EgeGurtunca/smart-safety-system/docs/CMP3010_SmartSafetySystem_Report.docx

T.C.

BAHÇEŞEHİR UNIVERSITY

FACULTY OF ENGINEERING AND NATURAL SCIENCES

DEPARTMENT OF COMPUTER ENGINEERING

PROJECT FINAL REPORT

SMART SAFETY SYSTEM

AN IOT BASED GAS, FLAME AND HEAT DETECTOR WITH REMOTE CONTROL

CMP3010

Course Project

Ege Gürtünca

İSTANBUL, SEPTEMBER 2026

# TABLE OF CONTENTS

# 1 OVERVIEW

## 1.1 Problem Statement and Objectives

Gas leaks and house fires are still a common cause of injury and property damage. In Turkey many homes use LPG tubes for cooking and heating, so this is a real risk for a lot of families.

The problem with most detectors you can buy is simple: they only make a sound in the room where they are installed. If nobody is at home, nobody hears the buzzer. You find out that something happened when you come back, which can be hours later.

In this project I built a system that tries to fix that. It works like a normal detector when it is on its own, and it also sends its data to the internet so I can see it on my phone. I kept these two things separate on purpose. All the detection and the fan control run on the Arduino, and the Arduino never waits for the network. So if the Wi-Fi goes down or the server is offline, the detector still works. The internet part only adds reporting and a few optional commands on top.

My objectives were:

1. Detect three different things: gas with an MQ-2 sensor, flame with an infrared sensor, and a fast temperature rise with a DHT11.
2. React immediately on the device itself: turn on a 12 V fan through a relay, sound a buzzer, and show the state on two LEDs and a 16x2 LCD.
3. Save every reading to an SD card and to a database, so I can look at what happened afterwards.
4. Show live values, charts and an alarm list in an Android app and on a web page.
5. Send commands back to the device: turn the fan on, silence the buzzer, and change the alarm thresholds without uploading new code.
6. Notice when the system itself stops working, so a dead device is never shown as a safe device.

What I expected to finish, and what I did finish, is a working prototype on a breadboard. It is not a certified product. I did not test it against the standards that a real gas detector has to pass, and I would not tell anyone to use it instead of a proper detector.

## 1.2 Background Information

When I looked at what already exists, I found two groups of products.

The first group is normal detectors, the ones sold in hardware stores. Some of them are certified to standards like EN 50291 for carbon monoxide. They are cheap and they work, but they are closed boxes. You cannot read their data, you cannot connect anything to them, and the only thing they do is beep.

The second group is smart detectors like Nest Protect or Netatmo. These do send notifications to your phone, but they cost much more and they depend on the company's own cloud. If the company shuts the service down, you cannot do anything about it.

My project is somewhere between the two. It uses cheap parts, the server is mine, and it also has a fan, which neither group normally has.

About the sensors. The MQ-2 is a semiconductor sensor. Its resistance drops when there is LPG, methane, propane, hydrogen or smoke in the air. It cannot tell these gases apart, its readings drift with temperature and humidity, and it needs to be powered for 24 to 48 hours before the readings become stable. [2] The infrared flame sensor sees light in about the 760 to 1100 nm range, so it only detects a flame that is in front of it, inside a cone of roughly 60 degrees. The DHT11 measures temperature from 0 to 50 C with about 2 degrees of error, and humidity from 20 to 90 percent. [4]

Because the flame sensor only sees what is in front of it, a fire behind a sofa or a slow smouldering fire can produce no signal at all. That is why I also added heat detection based on how fast the temperature rises instead of a fixed limit. This is a standard method in fire detection. [3] A fixed limit is not very useful in a room, because a temperature that is strange in winter is normal in summer. But a rise of several degrees in one minute is strange in any season.

The benefit of this project is mostly the price. Buying every part new costs around 1350 TL, and I paid 545.59 TL of that because the lab supplied the boards and the sensors. Running it costs nothing, because every service I used has a free plan that is enough for one device. A family that would not spend money on a commercial smart detector can still get gas, flame and heat detection with a notification on the phone. And since everything is open, it can be repaired or extended later.

# 2 METHODOLOGY

## 2.1 Project design

The system has four parts. The Arduino Uno reads the sensors, decides if there is an alarm, and drives the relay, buzzer, LEDs and the LCD. The NodeMCU takes the readings from the Arduino over a serial connection and sends them to the internet. A Flask application on Render stores everything in a Supabase database. Finally an Android app written in Kotlin and a web page show the data to the user.

Figure 1 shows the whole system and how the data moves.

Figure 1. Overall design of the system and circuit schematic.

Readings go up once per second from the Arduino to the NodeMCU, and once every five seconds from the NodeMCU to the server as a small JSON message of about 88 bytes.

Commands go the other way, but I did not make a second connection for them. The server puts the commands inside its answer to the measurement POST, and the NodeMCU passes them to the Arduino. This way I did not need a second endpoint, a separate polling loop, or something like MQTT. The price is that a command can take up to five seconds to arrive, which is fine for a fan and a buzzer.

Commands are written as a state, not as an event. The server keeps one row with the wanted fan state, the mute flag and the thresholds, and the device gets the whole row every time. If one message is lost, the next one fixes it. If I had sent events like turn the fan on, a lost message would be lost forever.

There are three safety rules and I put all of them in the firmware, not in the app, so that a buggy app cannot break them:

7. The fan runs if alarm OR button OR remote command. So a remote command can only turn the fan on, never off. You cannot switch the fan off from the phone while there is a gas alarm, and that is on purpose.
8. The mute command only stops the buzzer. The fan and the LEDs keep working, and the server clears the mute by itself when the alarm ends. Otherwise one press would silence the system forever.
9. The thresholds are kept in EEPROM so they survive a power cut. They are only written when a value really changes, because EEPROM can only be written about 100000 times.

I had a number of problems while building this. Table 1 shows what they were and what I did about them.

Table 1. Problems I ran into and how I solved them.

Problem | What I did
ESP8266 pins are not 5 V safe | Added a voltage divider (1 kOhm and 2 kOhm) between Arduino D9 and NodeMCU D7, which gives 3.33 V
3.3 V signal going into a 5 V input | Connected it directly. The Arduino reads anything above 0.6 x VCC = 3.0 V as HIGH, so 3.3 V is enough. A divider here would break it
Commands arrived broken or two of them stuck together | SoftwareSerial cannot send and receive at the same time. I added an XOR checksum to every command, and the Arduino throws away any line that does not match
A cut command was applied only half way | Now the Arduino checks that all eight fields are there. If one is missing the line is thrown away
The Arduino ran out of RAM (80 percent used, LCD stayed blank, EEPROM values became garbage) | Wrapped all text in the F() macro so it is stored in flash instead of RAM. This brought it down to 64 percent
When the DHT11 failed, the word nan was sent and the whole JSON became invalid, so gas and flame data was lost too | Values that are not numbers are now sent as null
A dead device looked exactly like a safe device | The server now sends how old the last reading is. If it is older than 60 seconds the app and the web page show a warning instead of NORMAL
Two thresholds could never be reached | The DHT11 only measures 0 to 50 C and 20 to 90 percent humidity, so I limited the settings to those ranges

Table 2 lists what the system is supposed to do and how I checked it.

Table 2. Specifications and how they were tested.

Specification | Target | How I tested it
Gas and flame detection speed | Under 1 second | Timestamps in the Arduino serial monitor
Local reaction to an alarm | Fan, buzzer and LED | Watched it with a lighter near the flame sensor
How often data reaches the server | Every 5 seconds | Difference between created_at values in the database
How long a command takes | 5 seconds or less | Time between pressing the button and the CMD line appearing
Thresholds survive a power cut | Yes | Unplugged the board and read the values printed at start-up
Broken commands are rejected | All of them | Tested the checksum with five different broken lines
Noticing that the device is silent | 60 seconds or less | Record age reported by the server
Free RAM on the Arduino | More than 25 percent | Compiler output after uploading

## 2.2 Project components

Most of the boards and sensors came from the lab stock, and I bought the rest myself. My proposal form said ESP32 for the Wi-Fi side, but I built the system with a NodeMCU ESP8266 instead, because that is the board the lab had in stock when I collected my parts. It does the same job here, and I did not end up needing anything that the ESP32 has on top of it. Table 3 shows what I used, why each part suits the job, and what else I could have used.

Table 3. Components, why I chose them and the alternatives.

Component | Why I chose it | Alternative
Arduino Uno | 5 V logic works directly with all the sensors and the relay, and there are many examples online | Nano is the same but harder to prototype with. Mega has more RAM, but after the F() fix I did not need it
NodeMCU ESP8266 | It was the board available in the lab, and it has Wi-Fi and TLS built in, which is all this project needs | ESP32 has more memory and Bluetooth, but I did not need either
MQ-2 gas sensor | Detects LPG, methane and smoke, which covers what can happen in a kitchen | MQ-5 and MQ-9 are more specific but each covers less. One MQ-2 covers more
Infrared flame sensor | Reacts to an open flame immediately | UV sensors give fewer false alarms but are much more expensive
DHT11 | Gives temperature and humidity together and is cheap | DHT22 goes up to 80 C and is more accurate. This would make the heat alarm more useful
1 channel relay module | Keeps the 12 V fan circuit separate from the logic | A MOSFET would be silent and faster but gives no isolation
Micro SD card module | Keeps a local record even if the internet is down | The EEPROM on the Arduino is far too small for logging
16x2 LCD with I2C | Shows the values locally and only uses two pins | A parallel LCD would use six pins that I needed for other things

I did not need any special lab equipment. I worked on a breadboard at home with a multimeter and a soldering iron. For software I used the Arduino IDE for both boards, Android Studio for the app, and Python with Flask for the server. Render and Supabase host the server and the database on their free plans, so the running cost is zero.

# 3 WORK PLAN

## 3.1 Tasks and Time Line

I did this project alone, so instead of dividing the work between people I divided it into stages. First research and design, then building and coding, and finally testing and writing this report.

Two things decided the order. The server had to have the command endpoint before I could write the firmware that uses it, and the serial link from the NodeMCU to the Arduino had to work before I could test any remote control. The second one cost me the most time. I thought the command feature was finished for quite a while, but nothing was arriving at the Arduino. In the end it turned out that I had connected the transmit pin of one board to the transmit pin of the other, so neither direction could carry anything.

The term started on 27 July 2026, and the numbers in Table 4 are the weeks counted from that date. Nothing happened in the first two weeks. The project started in week 3, when I wrote the proposal, decided what the system had to do and ordered the parts I did not have. From there I worked until week 6, and the presentation is in week 7.

Table 4. The project Gantt chart, in weeks from 27 July 2026.

TASK LIST | 1 | 2 | 3 | 4 | 5 | 6 | 7
1. Research and design
1.1 Literature search and goals | | | X
1.2 Design and ordering the parts | | | X
2. Building and coding
2.1 Wiring the sensors, Arduino code | | | X | X
2.2 NodeMCU code and Wi-Fi | | | X | X
2.3 Flask server and database | | | X | X
2.4 Web page | | | | X | X
2.5 Android application | | | | | X | X
2.6 Command channel and integration | | | | X | X | X
3. Testing and documentation
3.1 Proposal | | | X
3.2 Testing and fixing | | | | | X | X
3.3 Report | | | | | | X
3.4 Presentation | | | | | | | X

## 3.2 Cost Proposal

Most of the parts came from the lab stock, so I did not pay for them. Table 5 lists everything the system uses, where each part came from, and what the parts I bought myself actually cost. The prices are the ones I paid at an online seller in September 2026. The server, the database and the notifications cost nothing, because the app asks my own server directly instead of using a push service, so I did not need a Firebase project or a Play Store account.

Table 5. Where each part came from and what I paid.

Component | Source | Cost (TL)
16x2 LCD with I2C adapter | Bought | 121.09
60x60x25 mm fan, 12 V 0.20 A | Bought | 149.51
8 x AA battery holder, the 12 V supply for the fan | Bought | 94.18
Male-male jumper wires, 40 pieces | Bought | 55.50
Male-female jumper wires, 40 pieces | Bought | 52.69
Push buttons, 10 pieces | Bought | 31.38
1 kOhm resistors, 50 pieces | Bought | 11.14
Green LEDs, 10 pieces | Bought | 10.65
Red LEDs, 10 pieces | Bought | 10.65
Heat shrink tubing, 1 m | Bought | 8.80
Arduino Uno | Lab stock | -
NodeMCU ESP8266 | Lab stock | -
MQ-2 gas sensor module | Lab stock | -
Infrared flame sensor module | Lab stock | -
DHT11 temperature and humidity sensor | Lab stock | -
1 channel relay module | Lab stock | -
Micro SD card module | Lab stock | -
220 Ohm resistors for the LEDs | Lab stock | -
Buzzer | Lab stock | -
Breadboard | Lab stock | -
Server, database and notifications | Free plans | 0
TOTAL I PAID | | 545.59

So the project cost me 545.59 TL. That number only covers the parts I bought. Someone who had to buy the lab parts as well would pay roughly 800 TL more for the two boards, the three sensors, the relay and the SD card module at the same seller, so building this system from scratch would cost around 1350 TL. The two most expensive items I bought, the fan and the battery holder, are both there because the fan runs on 12 V and has to stay separate from the 5 V logic.

# 4 REFERENCES

10. Arduino, Arduino Uno Rev3 Documentation, Available from: <https://docs.arduino.cc/hardware/uno-rev3> [3 September 2026]
11. Hanwei Electronics, MQ-2 Semiconductor Sensor for Combustible Gas, Datasheet, Available from: <https://www.pololu.com/file/download/MQ2.pdf> [3 September 2026]
12. National Fire Protection Association 2022, NFPA 72: National Fire Alarm and Signaling Code, chapter on heat detectors and rate of rise operation, NFPA, Quincy MA.
13. Aosong Electronics, DHT11 Humidity and Temperature Sensor, Datasheet, Available from: <https://www.mouser.com/datasheet/2/758/DHT11-Technical-Data-Sheet-Translated-Version-1143054.pdf> [3 September 2026]
14. Espressif Systems 2023, ESP8266EX Datasheet, version 6.9, Available from: <https://www.espressif.com/sites/default/files/documentation/0a-esp8266ex_datasheet_en.pdf> [3 September 2026]
15. European Committee for Standardization 2018, EN 50291-1: Electrical apparatus for the detection of carbon monoxide in domestic premises, CEN, Brussels.

# 5 PHOTOS

The photographs below have to be added by hand, because they cannot be produced from the source code.

16. The breadboard while building it, showing the sensor wiring and the voltage divider between the two boards.
17. The finished system running, with the LCD showing live values.
18. The system during an alarm, with the red LED on and the fan turning.
19. A screenshot of the Android app with the values, the controls and the charts.
20. A screenshot of the web page with the alarm chart and the alarm list.
21. A photo of me with the finished project.

# 6 APPENDIX

This part has the code. It is twelve files, grouped below by the part of the system they belong to. These parts only talk to each other through the interfaces I described in section 2.1.

## 6.1 Arduino firmware

This is the only part that can start an alarm or switch something on. It reads the three sensors, checks the gas, flame and heat conditions, drives the relay, buzzer, LEDs and LCD, writes a line to the SD card every two seconds, sends a measurement to the NodeMCU every second, and applies the commands that come back. The thresholds are kept in EEPROM. All the text is wrapped in the F() macro so it stays in flash. Without this the sketch fills up the 2 kB of RAM on the Uno and then the LCD stays blank and the EEPROM values get corrupted, which is exactly what happened to me. The tone() call only runs when the state changes, because that function sets up Timer2 again every time it is called and the loop runs a few thousand times per second.

#include <Wire.h>

#include <LiquidCrystal_I2C.h>

#include <DHT.h>

#include <SPI.h>

#include <SD.h>

#include <SoftwareSerial.h>

#include <EEPROM.h>

#define MQ2_PIN A0

#define FLAME_PIN A1

#define DHT_PIN 2

#define DHT_TYPE DHT11

#define BUZZER_PIN 3

#define BUTTON_PIN 4

#define RELAY_PIN 5

#define GREEN_LED 6

#define RED_LED 7

// Arduino -> NodeMCU

#define NODE_RX 8

#define NODE_TX 9

#define SD_CS 10

#define GAS_THRESHOLD_DEFAULT 400

#define FLAME_THRESHOLD_DEFAULT 80

// Sicaklik alarmi.

// TEMP_RISE: 60 saniyede bu kadar C yukselirse alarm. Yanginin imzasi

// mutlak sicaklik degil, hizli yukselistir -- mutlak esik yazin yanlis

// alarm verir, kisin gec kalir.

// TEMP_MAX: mutlak tavan, yavas yukselen durumu yakalar.

// DHT11 sadece 0-50 C olcuyor, 50 uzeri bir tavan hic tetiklenmez.

#define TEMP_RISE_DEFAULT 5

#define TEMP_MAX_DEFAULT 45

// 6 x 10 saniye = 60 saniyelik kayan pencere.

#define TEMP_HISTORY 6

#define TEMP_SAMPLE_MS 10000

#define RELAY_ON LOW

#define RELAY_OFF HIGH

// Nem uyari sinirlari. Alarm DEGIL: fan, buzzer ve role etkilenmez,

// sadece LCD'de donusumlu gosterilir.

//

// DHT11 nemi 20-90% RH araliginda olcuyor. Bu araligin disinda kalan

// bir sinir sensorden hic gelmeyecegi icin uyariyi olu birakir; bu

// yuzden varsayilanlar aralik icinde. Uzaktan ayarlanabilir.

#define HUMIDITY_HIGH_DEFAULT 80

#define HUMIDITY_LOW_DEFAULT 25

#define SCREEN_SWAP_MS 2000

// EEPROM: esikler elektrik kesintisinde kaybolmasin.

//

// Sihirli sayi 2 bayt: tek baytlik bir imzanin kartta kalmis rastgele

// bir bayta denk gelme ihtimali yuksek, o durumda cop degerler gecerli

// sanilir. Kayit duzeni degistiginde magic artiriliyor; boylece eski

// karttaki yarim veri ilk aciliste kendiliginden sifirlanir.

#define EEPROM_MAGIC 0xA55D

#define EEPROM_ADDR_MAGIC 0

#define EEPROM_ADDR_GAS 2

#define EEPROM_ADDR_FLAME 4

#define EEPROM_ADDR_TEMP_RISE 10

#define EEPROM_ADDR_TEMP_MAX 12

#define EEPROM_ADDR_TEMP_RISE_DEF 14

#define EEPROM_ADDR_TEMP_MAX_DEF 16

#define EEPROM_ADDR_HUM_HIGH 18

#define EEPROM_ADDR_HUM_LOW 20

#define EEPROM_ADDR_HUM_HIGH_DEF 22

#define EEPROM_ADDR_HUM_LOW_DEF 24

// Son damgalamada gecerli olan derleme varsayilanlari da saklaniyor.

// Kodda varsayilan degistirilip kart yeniden yuklendiginde EEPROM'daki

// eski deger degil derlenen deger kazansin diye: aksi halde #define

// degisikligi calisan sisteme hicbir zaman yansimaz.

#define EEPROM_ADDR_GAS_DEF 6

#define EEPROM_ADDR_FLAME_DEF 8

LiquidCrystal_I2C lcd(0x27, 16, 2);

DHT dht(DHT_PIN, DHT_TYPE);

SoftwareSerial nodeSerial(NODE_RX, NODE_TX);

bool sdOK = false;

// Uzaktan gelen komut durumu.

bool remoteFan = false;

bool remoteMute = false;

int gasThreshold = GAS_THRESHOLD_DEFAULT;

int flameThreshold = FLAME_THRESHOLD_DEFAULT;

int tempRise = TEMP_RISE_DEFAULT;

int tempMax = TEMP_MAX_DEFAULT;

int humidityHigh = HUMIDITY_HIGH_DEFAULT;

int humidityLow = HUMIDITY_LOW_DEFAULT;

// Sicaklik gecmisi: 10 saniyede bir ornek, 60 saniye once ile karsilastirilir.

float tempHistory[TEMP_HISTORY];

byte tempIndex = 0;

bool tempHistoryFull = false;

unsigned long lastTempSample = 0;

// DHT11 saniyede birden fazla okumada nan doner ve ~250 ms bloklar,

// bu yuzden zamanlayiciya bagli ve deger onbellekleniyor.

float temperature = NAN;

float humidity = NAN;

unsigned long lastLog = 0;

unsigned long lastLCD = 0;

unsigned long lastNodeSend = 0;

unsigned long lastDHT = 0;

unsigned long lastPrint = 0;

unsigned long lastScreenSwap = 0;

// LCD nem uyari ekranini mi gosteriyor?

bool showHumidityScreen = false;

// Buzzer su an caliyor mu? tone() gereksiz yere tekrar cagrilmasin.

bool buzzerOn = false;

// NodeMCU'dan gelen komut satiri. Uno'da RAM kisitli:

// SD + LCD + DHT + SoftwareSerial zaten yer yiyor, String kullanilmiyor.

char cmdBuf[48];

byte cmdLen = 0;

// -------------------------

// EEPROM

// -------------------------

void saveThresholds() {

uint16_t magic = EEPROM_MAGIC;

int gasDefault = GAS_THRESHOLD_DEFAULT;

int flameDefault = FLAME_THRESHOLD_DEFAULT;

// EEPROM.put degismeyen baytlari yazmiyor; ayrica sadece

// deger degistiginde cagriliyor (~100k yazim omru).

int riseDefault = TEMP_RISE_DEFAULT;

int maxDefault = TEMP_MAX_DEFAULT;

int humHighDefault = HUMIDITY_HIGH_DEFAULT;

int humLowDefault = HUMIDITY_LOW_DEFAULT;

EEPROM.put(EEPROM_ADDR_MAGIC, magic);

EEPROM.put(EEPROM_ADDR_GAS, gasThreshold);

EEPROM.put(EEPROM_ADDR_FLAME, flameThreshold);

EEPROM.put(EEPROM_ADDR_TEMP_RISE, tempRise);

EEPROM.put(EEPROM_ADDR_TEMP_MAX, tempMax);

EEPROM.put(EEPROM_ADDR_HUM_HIGH, humidityHigh);

EEPROM.put(EEPROM_ADDR_HUM_LOW, humidityLow);

EEPROM.put(EEPROM_ADDR_GAS_DEF, gasDefault);

EEPROM.put(EEPROM_ADDR_FLAME_DEF, flameDefault);

EEPROM.put(EEPROM_ADDR_TEMP_RISE_DEF, riseDefault);

EEPROM.put(EEPROM_ADDR_TEMP_MAX_DEF, maxDefault);

EEPROM.put(EEPROM_ADDR_HUM_HIGH_DEF, humHighDefault);

EEPROM.put(EEPROM_ADDR_HUM_LOW_DEF, humLowDefault);

}

void loadThresholds() {

uint16_t magic = 0;

EEPROM.get(EEPROM_ADDR_MAGIC, magic);

if (magic != EEPROM_MAGIC) {

// Ilk acilis ya da eski/bozuk icerik: varsayilanlari damgala.

saveThresholds();

return;

}

int gasDefault;

int flameDefault;

int riseDefault;

int maxDefault;

int humHighDefault;

int humLowDefault;

EEPROM.get(EEPROM_ADDR_GAS_DEF, gasDefault);

EEPROM.get(EEPROM_ADDR_FLAME_DEF, flameDefault);

EEPROM.get(EEPROM_ADDR_TEMP_RISE_DEF, riseDefault);

EEPROM.get(EEPROM_ADDR_TEMP_MAX_DEF, maxDefault);

EEPROM.get(EEPROM_ADDR_HUM_HIGH_DEF, humHighDefault);

EEPROM.get(EEPROM_ADDR_HUM_LOW_DEF, humLowDefault);

if (gasDefault != GAS_THRESHOLD_DEFAULT ||

flameDefault != FLAME_THRESHOLD_DEFAULT ||

riseDefault != TEMP_RISE_DEFAULT ||

maxDefault != TEMP_MAX_DEFAULT ||

humHighDefault != HUMIDITY_HIGH_DEFAULT ||

humLowDefault != HUMIDITY_LOW_DEFAULT) {

// Kodda varsayilan degistirilmis: derlenen deger kazanir,

// EEPROM'daki eski deger uzerine yazilir.

Serial.println(F("Kod varsayilanlari degismis, EEPROM sifirlandi"));

saveThresholds();

return;

}

int g;

int f;

int r;

int m;

int hh;

int hl;

EEPROM.get(EEPROM_ADDR_GAS, g);

EEPROM.get(EEPROM_ADDR_FLAME, f);

EEPROM.get(EEPROM_ADDR_TEMP_RISE, r);

EEPROM.get(EEPROM_ADDR_TEMP_MAX, m);

EEPROM.get(EEPROM_ADDR_HUM_HIGH, hh);

EEPROM.get(EEPROM_ADDR_HUM_LOW, hl);

// Cop deger okunursa varsayilanda kal.

if (g >= 0 && g <= 1023) {

gasThreshold = g;

}

if (f >= 0 && f <= 1023) {

flameThreshold = f;

}

if (r >= 1 && r <= 30) {

tempRise = r;

}

if (m >= 0 && m <= 50) {

tempMax = m;

}

// DHT11 araligi disinda bir esik uyariyi olu birakir.

if (hh >= 20 && hh <= 90 && hl >= 20 && hl <= 90 && hh > hl) {

humidityHigh = hh;

humidityLow = hl;

}

}

// -------------------------

// KOMUT: #F1,M0,G400,L80,R5,X45,H80,W25

// -------------------------

// Anahtar yoksa ya da ardindan rakam gelmiyorsa bu deger doner.

// Mevcut degere sessizce dusmek, kesilmis bir satirin yarim

// uygulanmasi anlamina gelir.

#define FIELD_MISSING -32000

int fieldValue(const char *line, char key) {

const char *p = strchr(line, key);

if (!p) {

return FIELD_MISSING;

}

p++;

if (*p == '-' || *p == '+') {

p++;

}

if (!isdigit((unsigned char)*p)) {

return FIELD_MISSING;

}

return atoi(strchr(line, key) + 1);

}

/**

* XOR sagalamasi: '#' ile '*' arasindaki karakterlerin XOR'u.

*

* SoftwareSerial yari cift yonlu -- Arduino nodeSerial.print() ile

* veri gonderirken (saniyede bir, kesmeler kapali) ayni anda alamiyor.

* Komut tam o pencerede gelirse baytlar kayboluyor, satir sonu da

* kaybolunca iki komut birbirine yapisiyor. Bozuk satiri uygulamak

* cihaza sacma esik yazar; sagalama tutmuyorsa satiri atiyoruz.

* NodeMCU 5 saniyede bir tekrar gonderiyor, kayip sorun degil.

*/

bool checksumOk(const char *line) {

const char *star = strrchr(line, '*');

if (!star || star == line) {

return false;

}

byte sum = 0;

for (const char *p = line + 1; p < star; p++) {

sum ^= (byte)(*p);

}

return (byte)strtol(star + 1, NULL, 16) == sum;

}

void applyCommand(const char *line) {

if (line[0] != '#') {

return;

}

if (!checksumOk(line)) {

Serial.print(F("CMD BOZUK, atlandi: "));

Serial.println(line);

return;

}

int fanValue = fieldValue(line, 'F');

int muteValue = fieldValue(line, 'M');

int g = fieldValue(line, 'G');

int f = fieldValue(line, 'L');

int r = fieldValue(line, 'R');

int x = fieldValue(line, 'X');

int hh = fieldValue(line, 'H');

int hl = fieldValue(line, 'W');

// Sekiz alanin biri bile eksikse satir kesilmis demektir.

if (fanValue == FIELD_MISSING || muteValue == FIELD_MISSING ||

g == FIELD_MISSING || f == FIELD_MISSING ||

r == FIELD_MISSING || x == FIELD_MISSING ||

hh == FIELD_MISSING || hl == FIELD_MISSING) {

Serial.print(F("CMD EKSIK ALAN, atlandi: "));

Serial.println(line);

return;

}

remoteFan = fanValue != 0;

remoteMute = muteValue != 0;

if (g >= 0 && g <= 1023 &&

f >= 0 && f <= 1023 &&

r >= 1 && r <= 30 &&

x >= 0 && x <= 50 &&

hh >= 20 && hh <= 90 && hl >= 20 && hl <= 90 && hh > hl &&

(g != gasThreshold || f != flameThreshold ||

r != tempRise || x != tempMax ||

hh != humidityHigh || hl != humidityLow)) {

gasThreshold = g;

flameThreshold = f;

tempRise = r;

tempMax = x;

humidityHigh = hh;

humidityLow = hl;

saveThresholds();

Serial.print(F("EEPROM yazildi G:"));

Serial.print(gasThreshold);

Serial.print(F(" L:"));

Serial.print(flameThreshold);

Serial.print(F(" R:"));

Serial.print(tempRise);

Serial.print(F(" X:"));

Serial.print(tempMax);

Serial.print(F(" H:"));

Serial.print(humidityHigh);

Serial.print(F(" W:"));

Serial.println(humidityLow);

}

Serial.print(F("CMD alindi: "));

Serial.println(line);

}

void readCommand() {

while (nodeSerial.available()) {

char c = nodeSerial.read();

if (c == '\n' || c == '\r') {

if (cmdLen > 0) {

cmdBuf[cmdLen] = '\0';

applyCommand(cmdBuf);

cmdLen = 0;

}

continue;

}

if (cmdLen < sizeof(cmdBuf) - 1) {

cmdBuf[cmdLen++] = c;

} else {

// Tasma: bozuk satiri at, yarim komut uygulama.

cmdLen = 0;

}

}

}

void setup() {

Serial.begin(9600);

nodeSerial.begin(9600);

pinMode(BUZZER_PIN, OUTPUT);

pinMode(BUTTON_PIN, INPUT_PULLUP);

pinMode(RELAY_PIN, OUTPUT);

pinMode(GREEN_LED, OUTPUT);

pinMode(RED_LED, OUTPUT);

digitalWrite(RELAY_PIN, RELAY_OFF);

digitalWrite(GREEN_LED, HIGH);

digitalWrite(RED_LED, LOW);

noTone(BUZZER_PIN);

loadThresholds();

for (byte i = 0; i < TEMP_HISTORY; i++) {

tempHistory[i] = NAN;

}

dht.begin();

lcd.init();

lcd.backlight();

lcd.clear();

lcd.setCursor(0, 0);

lcd.print(F("SMART SYSTEM"));

lcd.setCursor(0, 1);

lcd.print(F("Starting..."));

delay(1500);

if (SD.begin(SD_CS)) {

sdOK = true;

if (!SD.exists("log.csv")) {

File file = SD.open("log.csv", FILE_WRITE);

if (file) {

file.println(

F("Time,Temperature,Humidity,Gas,Flame,Button,Fan,Alarm")

);

file.close();

}

}

Serial.println(F("SD OK"));

} else {

Serial.println(F("SD FAILED"));

}

Serial.print(F("Esikler G:"));

Serial.print(gasThreshold);

Serial.print(F(" L:"));

Serial.print(flameThreshold);

Serial.print(F(" R:"));

Serial.print(tempRise);

Serial.print(F(" X:"));

Serial.print(tempMax);

Serial.print(F(" H:"));

Serial.print(humidityHigh);

Serial.print(F(" W:"));

Serial.println(humidityLow);

lcd.clear();

lcd.print(F("SYSTEM READY"));

delay(1000);

lcd.clear();

}

void loop() {

// -------------------------

// KOMUT OKU

// -------------------------

readCommand();

// -------------------------

// SENSORLAR

// -------------------------

int gasValue = analogRead(MQ2_PIN);

int flameValue = analogRead(FLAME_PIN);

if (millis() - lastDHT >= 2000) {

lastDHT = millis();

temperature = dht.readTemperature();

humidity = dht.readHumidity();

}

bool buttonPressed =

(digitalRead(BUTTON_PIN) == LOW);

// -------------------------

// ALARM

// -------------------------

bool gasAlarm =

gasValue >= gasThreshold;

bool flameAlarm =

flameValue <= flameThreshold;

// -------------------------

// SICAKLIK

//

// 10 saniyede bir ornek alinip 60 saniye oncekiyle karsilastiriliyor.

// Yanginin imzasi mutlak sicaklik degil hizli yukselis; mutlak esik

// tek basina yazin yanlis alarm verir, kisin gec kalir.

// -------------------------

if (millis() - lastTempSample >= TEMP_SAMPLE_MS) {

lastTempSample = millis();

tempHistory[tempIndex] = temperature;

tempIndex = (tempIndex + 1) % TEMP_HISTORY;

if (tempIndex == 0) {

tempHistoryFull = true;

}

}

bool tempAlarm = false;

if (!isnan(temperature)) {

if (temperature >= tempMax) {

tempAlarm = true;

}

if (tempHistoryFull) {

// tempIndex, uzerine yazilacak olan slot: yani en eski ornek.

float oldest = tempHistory[tempIndex];

if (!isnan(oldest) && (temperature - oldest) >= tempRise) {

tempAlarm = true;

}

}

}

bool alarm =

gasAlarm || flameAlarm || tempAlarm;

// -------------------------

// FAN

// -------------------------

// Uzaktan sadece ACILIR. Alarm varken telefondan fan kapatilamaz.

bool fanOn = alarm || buttonPressed || remoteFan;

digitalWrite(

RELAY_PIN,

fanOn ? RELAY_ON : RELAY_OFF

);

// -------------------------

// LED

// -------------------------

if (alarm) {

digitalWrite(RED_LED, HIGH);

digitalWrite(GREEN_LED, LOW);

} else {

digitalWrite(RED_LED, LOW);

digitalWrite(GREEN_LED, HIGH);

}

// -------------------------

// BUZZER

// -------------------------

// Susturma sadece sesi keser; fan ve LED calismaya devam eder.

//

// tone() her cagrildiginda Timer2'yi bastan kuruyor. Dongu saniyede

// binlerce kez dondugu icin surekli cagrilirsa dalga formu hic

// tamamlanamaz ve buzzer ya hic otmez ya cilizca oter. Bu yuzden

// sadece durum degistiginde cagriliyor.

bool wantBuzzer = alarm && !remoteMute;

if (wantBuzzer != buzzerOn) {

buzzerOn = wantBuzzer;

if (buzzerOn) {

tone(BUZZER_PIN, 1000);

} else {

noTone(BUZZER_PIN);

}

}

// -------------------------

// LCD

// -------------------------

// Nem sinir disindaysa LCD 2 saniye normal degerleri, 2 saniye

// uyariyi gosterir. Alarm varken uyari ekrani devre disi:

// o anda ekranda sensor degerleri durmali.

bool humidityWarn =

!isnan(humidity) &&

(humidity >= humidityHigh || humidity <= humidityLow);

if (!humidityWarn || alarm) {

showHumidityScreen = false;

lastScreenSwap = millis();

} else if (millis() - lastScreenSwap >= SCREEN_SWAP_MS) {

lastScreenSwap = millis();

showHumidityScreen = !showHumidityScreen;

}

if (millis() - lastLCD >= 1000) {

lastLCD = millis();

lcd.clear();

if (showHumidityScreen) {

lcd.setCursor(0, 0);

lcd.print(F("NEM UYARISI"));

lcd.setCursor(0, 1);

lcd.print(F("%"));

lcd.print(humidity, 0);

if (humidity >= humidityHigh) {

lcd.print(F(" COK NEMLI"));

} else {

lcd.print(F(" COK KURU"));

}

} else {

lcd.setCursor(0, 0);

if (isnan(temperature)) {

lcd.print(F("T:ERR"));

} else {

lcd.print(F("T:"));

lcd.print(temperature, 1);

lcd.print(F("C"));

}

lcd.print(F(" "));

if (isnan(humidity)) {

lcd.print(F("H:ERR"));

} else {

lcd.print(F("H:"));

lcd.print(humidity, 0);

lcd.print(F("%"));

}

lcd.setCursor(0, 1);

lcd.print(F("G:"));

lcd.print(gasValue);

lcd.print(F(" F:"));

lcd.print(flameValue);

if (alarm) {

lcd.setCursor(15, 1);

lcd.print(remoteMute ? "M" : "!");

}

}

}

// -------------------------

// SD CARD

// -------------------------

if (sdOK && millis() - lastLog >= 2000) {

lastLog = millis();

File file =

SD.open("log.csv", FILE_WRITE);

if (file) {

file.print(millis());

file.print(",");

file.print(temperature);

file.print(",");

file.print(humidity);

file.print(",");

file.print(gasValue);

file.print(",");

file.print(flameValue);

file.print(",");

file.print(buttonPressed);

file.print(",");

file.print(fanOn);

file.print(",");

file.println(alarm);

file.close();

}

}

// -------------------------

// NODEMCU'YA VERI GONDER

// FN son alan olmali, NodeMCU satir sonuna kadar okuyor.

// -------------------------

if (millis() - lastNodeSend >= 1000) {

lastNodeSend = millis();

nodeSerial.print(F("@"));

nodeSerial.print(F("T="));

nodeSerial.print(temperature);

nodeSerial.print(F(",H="));

nodeSerial.print(humidity);

nodeSerial.print(F(",G="));

nodeSerial.print(gasValue);

nodeSerial.print(F(",F="));

nodeSerial.print(flameValue);

nodeSerial.print(F(",A="));

nodeSerial.print(alarm);

nodeSerial.print(F(",B="));

nodeSerial.print(buttonPressed);

nodeSerial.print(F(",FN="));

nodeSerial.println(fanOn);

}

// -------------------------

// ARDUINO SERIAL MONITOR

// -------------------------

if (millis() - lastPrint >= 1000) {

lastPrint = millis();

Serial.print(F("Temperature: "));

Serial.print(temperature);

Serial.print(F(" | Humidity: "));

Serial.print(humidity);

Serial.print(F(" | Gas: "));

Serial.print(gasValue);

Serial.print(F("/"));

Serial.print(gasThreshold);

Serial.print(F(" | Flame: "));

Serial.print(flameValue);

Serial.print(F("/"));

Serial.print(flameThreshold);

Serial.print(F(" | Button: "));

Serial.print(buttonPressed);

Serial.print(F(" | Fan: "));

Serial.print(fanOn);

Serial.print(F(" | RemoteFan: "));

Serial.print(remoteFan);

Serial.print(F(" | Mute: "));

Serial.print(remoteMute);

Serial.print(F(" | TempAlarm: "));

Serial.print(tempAlarm);

Serial.print(F(" | Alarm: "));

Serial.println(alarm);

}

}

## 6.2 NodeMCU firmware

This part only carries data, it makes no decisions. It reads the line coming from the Arduino, sends it to the server as JSON over TLS, takes the command out of the answer, and passes it back to the Arduino with a checksum at the end. Values that are not numbers, which happens when the DHT11 fails to read, are sent as null. Sending the word nan made the JSON invalid and the server rejected the whole record. The receive buffer is set to 256 bytes because the TLS handshake blocks the loop for one to three seconds and the Arduino keeps sending during that time.

#include <ESP8266WiFi.h>

#include <SoftwareSerial.h>

#include <ESP8266HTTPClient.h>

#include <WiFiClientSecureBearSSL.h>

// =================================================

// WIFI

// =================================================

// Kendi ag bilgilerini gir

const char* ssid = "YOUR_WIFI_SSID";

const char* password = "YOUR_WIFI_PASSWORD";

// =================================================

// RENDER API

// =================================================

const char* serverURL =

"https://smart-safety-system-y11a.onrender.com/api/data";

// Render'daki API_TOKEN ortam degiskeniyle ayni olmali.

const char* apiToken = "YOUR_API_TOKEN";

// =================================================

// ARDUINO <-> NODEMCU

//

// D7 = RX <- Arduino D9 (TX), gerilim bolucu uzerinden

// Bolucu sart: Arduino 5V veriyor, ESP8266 pinleri

// 5V toleransli degil.

//

// D6 = TX -> Arduino D8 (RX), dogrudan

// Bolucu YOK: 3.3V zaten Arduino'nun HIGH esigi olan

// 3.0V'un ustunde. Bolunse esigin altina duserdi.

// =================================================

SoftwareSerial arduinoSerial(D7, D6);

// =================================================

// SENSOR VALUES

// =================================================

String temperature = "--";

String humidity = "--";

String gas = "--";

String flame = "--";

String alarm = "0";

String fan = "0";

String button = "0";

// =================================================

// KOMUT (sunucudan inen istenen durum)

// =================================================

int cmdFan = 0;

int cmdMute = 0;

int cmdGas = 400;

int cmdFlame = 80;

int cmdTempRise = 5;

int cmdTempMax = 45;

int cmdHumHigh = 80;

int cmdHumLow = 25;

unsigned long lastSend = 0;

unsigned long lastBlink = 0;

bool ledState = HIGH;

// =================================================

// LOG

//

// Log sadece USB seri porta gidiyor, RAM'de biriktirilmiyor.

// HTTPS el sikismasi tek basina ~20 KB heap istiyor; birikip

// duran String'ler heap'i parcalayip baglantiyi dusuruyor.

// =================================================

void addLog(String text) {

Serial.println(text);

}

// =================================================

// JSON YARDIMCISI

//

// Arduino DHT okuyamazsa "nan" gonderiyor. Ham haliyle JSON'a

// girerse gecersiz JSON olur, Flask 400 doner ve o turun TAMAMI

// -- gaz ve alev dahil -- kaybolur. Sayi degilse null yaz.

// =================================================

String jsonNumber(String value) {

value.trim();

if (value.length() == 0)

return "null";

char first = value.charAt(0);

if (!isDigit(first) && first != '-' && first != '+')

return "null";

return value;

}

// =================================================

// SUNUCU CEVABINDAN SAYI CEK

// =================================================

int extractInt(String src, String key, int fallback) {

int start = src.indexOf("\"" + key + "\":");

if (start < 0)

return fallback;

start += key.length() + 3;

int end = start;

while (end < (int)src.length()) {

char c = src.charAt(end);

if (!isDigit(c) && c != '-')

break;

end++;

}

if (end == start)

return fallback;

return src.substring(start, end).toInt();

}

// =================================================

// ARDUINO DATA READER

// =================================================

void readArduinoData() {

while (arduinoSerial.available()) {

String data =

arduinoSerial.readStringUntil('\n');

data.trim();

if (data.length() == 0)

continue;

// Ham satiri her zaman bas. Bu satir olmadan "hic byte gelmiyor" ile

// "bozuk byte geliyor" ayirt edilemiyor.

addLog("ARDUINO: " + data);

// ---------------------------------------------

// Beklenen format:

//

// @T=25.9,H=74,G=76,F=160,A=0,B=0,FN=0

// ---------------------------------------------

if (!data.startsWith("@")) {

addLog(" (@ ile baslamiyor, atlandi)");

continue;

}

data.remove(0, 1);

int start;

int end;

// ---------------------------------------------

// TEMPERATURE

// ---------------------------------------------

start = data.indexOf("T=");

if (start >= 0) {

end = data.indexOf(',', start);

if (end >= 0) {

temperature = data.substring(start + 2, end);

}

}

// ---------------------------------------------

// HUMIDITY

// ---------------------------------------------

start = data.indexOf("H=");

if (start >= 0) {

end = data.indexOf(',', start);

if (end >= 0) {

humidity = data.substring(start + 2, end);

}

}

// ---------------------------------------------

// GAS

// ---------------------------------------------

start = data.indexOf("G=");

if (start >= 0) {

end = data.indexOf(',', start);

if (end >= 0) {

gas = data.substring(start + 2, end);

}

}

// ---------------------------------------------

// FLAME

// ---------------------------------------------

start = data.indexOf("F=");

if (start >= 0) {

end = data.indexOf(',', start);

if (end >= 0) {

flame = data.substring(start + 2, end);

}

}

// ---------------------------------------------

// ALARM

// ---------------------------------------------

start = data.indexOf("A=");

if (start >= 0) {

end = data.indexOf(',', start);

if (end >= 0) {

alarm = data.substring(start + 2, end);

}

}

// ---------------------------------------------

// BUTTON

// ---------------------------------------------

start = data.indexOf("B=");

if (start >= 0) {

end = data.indexOf(',', start);

if (end >= 0) {

button = data.substring(start + 2, end);

}

}

// ---------------------------------------------

// FAN (son alan, satir sonuna kadar)

// ---------------------------------------------

start = data.indexOf("FN=");

if (start >= 0) {

fan = data.substring(start + 3);

}

addLog(

"PARSED -> T:" + temperature +

" H:" + humidity +

" G:" + gas +

" F:" + flame +

" BTN:" + button +

" FAN:" + fan +

" ALARM:" + alarm

);

}

}

// =================================================

// KOMUTU ARDUINO'YA GONDER

// =================================================

void sendCommandToArduino() {

String line =

"#F" + String(cmdFan) +

",M" + String(cmdMute) +

",G" + String(cmdGas) +

",L" + String(cmdFlame) +

",R" + String(cmdTempRise) +

",X" + String(cmdTempMax) +

",H" + String(cmdHumHigh) +

",W" + String(cmdHumLow);

// XOR sagalamasi. Arduino'nun SoftwareSerial'i gonderirken alamiyor;

// cakisma olursa satir bozuluyor ya da iki komut birbirine yapisiyor.

// Sagalama tutmazsa Arduino satiri atiyor.

byte sum = 0;

for (unsigned int i = 1; i < line.length(); i++) {

sum ^= (byte)line[i];

}

char tail[5];

sprintf(tail, "*%02X", sum);

line += tail;

arduinoSerial.println(line);

addLog("CMD -> " + line);

}

// =================================================

// SEND DATA TO RENDER

// =================================================

void sendToServer() {

if (WiFi.status() != WL_CONNECTED) {

addLog("ERROR: WiFi disconnected");

return;

}

// HTTPS client

std::unique_ptr<BearSSL::WiFiClientSecure> client(

new BearSSL::WiFiClientSecure

);

// Test/prototype icin certificate verification kapali

client->setInsecure();

HTTPClient https;

if (!https.begin(*client, serverURL)) {

addLog("ERROR: HTTPS connection failed");

return;

}

https.addHeader("Content-Type", "application/json");

https.addHeader("X-Auth", apiToken);

// ---------------------------------------------

// JSON

// ---------------------------------------------

String json = "{";

json += "\"temperature\":";

json += jsonNumber(temperature);

json += ",";

json += "\"humidity\":";

json += jsonNumber(humidity);

json += ",";

json += "\"gas\":";

json += jsonNumber(gas);

json += ",";

json += "\"flame\":";

json += jsonNumber(flame);

json += ",";

json += "\"button\":";

json += jsonNumber(button);

json += ",";

json += "\"fan\":";

json += jsonNumber(fan);

json += ",";

json += "\"alarm\":";

json += jsonNumber(alarm);

json += "}";

addLog("JSON: " + json);

// ---------------------------------------------

// POST

// ---------------------------------------------

int httpCode = https.POST(json);

if (httpCode > 0) {

addLog("HTTP CODE: " + String(httpCode));

String response = https.getString();

addLog("SERVER: " + response);

// -------------------------------------------

// Komut cevaba binmis halde geliyor:

// {"success":true,"cmd":{"fan":0,"mute":0,"gt":400,"ft":80,"tr":5,"tm":45,"hh":80,"hl":25}}

// -------------------------------------------

if (httpCode == 200 && response.indexOf("\"cmd\"") >= 0) {

int fanValue = extractInt(response, "fan", -1);

int muteValue = extractInt(response, "mute", -1);

int gasValue = extractInt(response, "gt", -1);

int flameValue = extractInt(response, "ft", -1);

int riseValue = extractInt(response, "tr", -1);

int maxValue = extractInt(response, "tm", -1);

int humHighValue = extractInt(response, "hh", -1);

int humLowValue = extractInt(response, "hl", -1);

if (fanValue >= 0 && muteValue >= 0 &&

gasValue >= 0 && flameValue >= 0 &&

riseValue >= 0 && maxValue >= 0 &&

humHighValue >= 0 && humLowValue >= 0) {

cmdFan = fanValue;

cmdMute = muteValue;

cmdGas = gasValue;

cmdFlame = flameValue;

cmdTempRise = riseValue;

cmdTempMax = maxValue;

cmdHumHigh = humHighValue;

cmdHumLow = humLowValue;

sendCommandToArduino();

} else {

addLog("CMD: eksik alan, gonderilmedi");

}

}

} else {

addLog("POST ERROR: " + https.errorToString(httpCode));

}

https.end();

}

// =================================================

// SETUP

// =================================================

void setup() {

// USB serial

Serial.begin(9600);

// Arduino serial.

//

// Varsayilan 64 baytlik tampon yetmiyor: sendToServer() TLS el

// sikismasi icin 1-3 saniye bloklarken Arduino saniyede bir ~45

// baytlik satir gonderiyor, ikinci satirda tampon tasiyor.

arduinoSerial.begin(9600, SWSERIAL_8N1, D7, D6, false, 256);

// Satir sonu gelmezse 1 saniye kilitlenmesin.

arduinoSerial.setTimeout(200);

pinMode(LED_BUILTIN, OUTPUT);

digitalWrite(LED_BUILTIN, HIGH);

delay(500);

addLog("==========================");

addLog("SMART SAFETY NODEMCU");

addLog("==========================");

// ---------------------------------------------

// WIFI

// ---------------------------------------------

WiFi.mode(WIFI_STA);

WiFi.begin(ssid, password);

addLog("Connecting to WiFi...");

while (WiFi.status() != WL_CONNECTED) {

delay(500);

Serial.print(".");

}

Serial.println();

addLog("WiFi CONNECTED!");

addLog("IP: " + WiFi.localIP().toString());

addLog("Waiting for Arduino data...");

}

// =================================================

// LOOP

// =================================================

void loop() {

// Arduino'dan veri al

readArduinoData();

// Her 5 saniyede Render'a gonder

if (millis() - lastSend >= 5000) {

lastSend = millis();

// Eger henuz veri alinmadiysa gonderme

if (temperature != "--") {

sendToServer();

} else {

addLog("Waiting for Arduino data...");

}

}

// 1 saniyede bir LED

if (millis() - lastBlink >= 1000) {

lastBlink = millis();

ledState = !ledState;

digitalWrite(LED_BUILTIN, ledState);

}

}

## 6.3 Server application

The Flask app takes the measurements, saves them to Supabase, and puts the current commands in the answer to the same request. It also notices when the alarm turns on so it can send a notification, clears the mute flag when the alarm ends, serves the web page, and reports how old the last reading is so the app can tell a dead device from a safe one. Threshold values are checked against the sensor ranges before they are saved.

import os

import urllib.parse

import urllib.request

from datetime import datetime, timedelta, timezone

from functools import wraps

from flask import Flask, request, jsonify, render_template

from supabase import create_client

app = Flask(__name__)

SUPABASE_URL = os.environ.get("SUPABASE_URL")

SUPABASE_KEY = os.environ.get("SUPABASE_KEY")

API_TOKEN = os.environ.get("API_TOKEN")

TELEGRAM_BOT_TOKEN = os.environ.get("TELEGRAM_BOT_TOKEN")

TELEGRAM_CHAT_ID = os.environ.get("TELEGRAM_CHAT_ID")

supabase = (

create_client(SUPABASE_URL, SUPABASE_KEY)

if SUPABASE_URL and SUPABASE_KEY

else None

)

# Telefonda cizilecek nokta sayisi. 1 saat ham veri ~720 nokta, cok fazla.

MAX_POINTS = 120

# Sensor titrerse arka arkaya bildirim yagmasin.

NOTIFY_COOLDOWN_MINUTES = 5

DEFAULT_COMMAND = {

"fan_request": False,

"mute": False,

"gas_threshold": 400,

"flame_threshold": 80,

"temp_rise": 5,

"temp_max": 45,

"humidity_high": 80,

"humidity_low": 25

}

# DHT11 sadece 0-50 C olcuyor; ustundeki bir tavan hic tetiklenmez.

TEMP_MAX_LIMIT = 50

# DHT11 nemi 20-90% RH olcuyor. Disindaki bir esik uyariyi olu birakir.

HUMIDITY_MIN_LIMIT = 20

HUMIDITY_MAX_LIMIT = 90

# Cihaz 5 saniyede bir gonderiyor. Bundan eski veri "akis durdu" demek.

STALE_SECONDS = 60

def now_iso():

return datetime.now(timezone.utc).isoformat()

def truthy(value):

"""Supabase kolonu bool da int de olabilir, NodeMCU 0/1 gonderiyor."""

if value is None:

return False

if isinstance(value, str):

return value.strip() not in ("", "0", "false", "False")

return bool(value)

def require_token(allow_open=False):

"""X-Auth header dogrulamasi.

API_TOKEN tanimli degilse allow_open=True olan uclar calismaya devam eder

(cihaz token kurulmadan once de veri gonderebilsin), yazma uclari reddedilir

-- kimse uzaktan fani acamasin.

"""

def decorator(f):

@wraps(f)

def wrapper(*args, **kwargs):

if not API_TOKEN:

if allow_open:

print("WARNING: API_TOKEN tanimli degil, /api/data korumasiz")

return f(*args, **kwargs)

return jsonify({

"success": False,

"error": "API_TOKEN sunucuda tanimli degil"

}), 503

if request.headers.get("X-Auth") != API_TOKEN:

return jsonify({

"success": False,

"error": "unauthorized"

}), 401

return f(*args, **kwargs)

return wrapper

return decorator

def alarm_edge(previous, current):

"""Alarm gecisi: 'rise', 'fall' veya None."""

was = truthy(previous)

now = truthy(current)

if now and not was:

return "rise"

if was and not now:

return "fall"

return None

def downsample(rows, max_points=MAX_POINTS):

"""Esit arayla seyreltir. Ilk ve son nokta her zaman korunur."""

if len(rows) <= max_points:

return rows

step = len(rows) / max_points

out = [rows[int(i * step)] for i in range(max_points)]

out[-1] = rows[-1]

return out

def read_command():

response = (

supabase

.table("commands")

.select("*")

.eq("id", 1)

.limit(1)

.execute()

)

if response.data:

return response.data[0]

return dict(DEFAULT_COMMAND)

def write_command(patch):

patch["updated_at"] = now_iso()

(

supabase

.table("commands")

.update(patch)

.eq("id", 1)

.execute()

)

def device_command(command):

"""Cihazin bekledigi kisa format."""

return {

"fan": int(truthy(command.get("fan_request"))),

"mute": int(truthy(command.get("mute"))),

"gt": int(command.get("gas_threshold") or DEFAULT_COMMAND["gas_threshold"]),

"ft": int(command.get("flame_threshold") or DEFAULT_COMMAND["flame_threshold"]),

"tr": int(command.get("temp_rise") or DEFAULT_COMMAND["temp_rise"]),

"tm": int(command.get("temp_max") or DEFAULT_COMMAND["temp_max"]),

"hh": int(command.get("humidity_high") or DEFAULT_COMMAND["humidity_high"]),

"hl": int(command.get("humidity_low") or DEFAULT_COMMAND["humidity_low"])

}

def send_telegram(text):

if not (TELEGRAM_BOT_TOKEN and TELEGRAM_CHAT_ID):

return

url = (

"https://api.telegram.org/bot" +

TELEGRAM_BOT_TOKEN +

"/sendMessage"

)

payload = urllib.parse.urlencode({

"chat_id": TELEGRAM_CHAT_ID,

"text": text

}).encode()

try:

# NodeMCU'nun POST timeout'u 5 sn; burada beklemek onun isteginin

# zaman asimina ugramasina yol acmasin.

urllib.request.urlopen(url, data=payload, timeout=3).close()

except Exception as e:

# Bildirim kaybi, veri kaybindan iyidir. POST'u dusurme.

print("TELEGRAM ERROR:", e)

def alarm_message(record, command):

reasons = []

limits = device_command(command)

gas = record.get("gas")

flame = record.get("flame")

temperature = record.get("temperature")

if gas is not None and gas >= limits["gt"]:

reasons.append("gaz " + str(gas))

if flame is not None and flame <= limits["ft"]:

reasons.append("alev " + str(flame))

if temperature is not None and temperature >= limits["tm"]:

reasons.append("sicaklik " + str(temperature))

# Hizli isinma alarmi cihazda 60 saniyelik pencereyle hesaplaniyor;

# sunucu tek kayda bakarak bunu goremez.

fallback = "belirlenemedi (hizli sicaklik yukselisi olabilir)"

return (

"ALARM - Smart Safety System\n"

"Sebep: " + (", ".join(reasons) if reasons else fallback) + "\n"

"Gaz: " + str(gas) + " Alev: " + str(flame) + "\n"

"Sicaklik: " + str(record.get("temperature")) + " C "

"Nem: " + str(record.get("humidity")) + " %"

)

def age_seconds(created_at):

"""Kaydin kac saniye once yazildigi.

Sunucu saatiyle hesaplaniyor: telefonun ya da tarayicinin saati

kaymissa istemci tarafinda yapilan hesap yaniltir. Olculemezse

None doner -- istemci "bilmiyorum" ile "taze" arasindaki farki

gorebilsin, eskiyi taze sanmasin.

"""

if not created_at:

return None

try:

stamp = datetime.fromisoformat(str(created_at).replace("Z", "+00:00"))

except ValueError:

return None

if stamp.tzinfo is None:

stamp = stamp.replace(tzinfo=timezone.utc)

return max(0, int((datetime.now(timezone.utc) - stamp).total_seconds()))

def cooldown_passed(command):

last = command.get("last_notified_at")

if not last:

return True

try:

stamp = datetime.fromisoformat(last.replace("Z", "+00:00"))

except ValueError:

return True

age = datetime.now(timezone.utc) - stamp

return age >= timedelta(minutes=NOTIFY_COOLDOWN_MINUTES)

@app.route("/")

def index():

return render_template("index.html")

@app.route("/health")

def health():

return jsonify({

"service": "smart-safety-system",

"ok": True,

"auth": bool(API_TOKEN)

})

@app.route("/api/data", methods=["POST"])

@require_token(allow_open=True)

def receive_data():

data = request.get_json(silent=True)

if not data:

return jsonify({

"success": False,

"error": "No JSON data"

}), 400

try:

record = {

"temperature": data.get("temperature"),

"humidity": data.get("humidity"),

"gas": data.get("gas"),

"flame": data.get("flame"),

"button": data.get("button"),

"fan": data.get("fan"),

"alarm": data.get("alarm")

}

previous = (

supabase

.table("sensor_data")

.select("alarm")

.order("created_at", desc=True)

.limit(1)

.execute()

)

previous_alarm = (

previous.data[0].get("alarm") if previous.data else None

)

supabase.table("sensor_data").insert(record).execute()

command = read_command()

edge = alarm_edge(previous_alarm, record["alarm"])

# Bildirim/susturma islerinin hatasi veri akisini dusurmemeli:

# cihaz komutunu alamazsa bir sonraki turda duzelir, veri geri gelmez.

try:

if edge == "fall" and truthy(command.get("mute")):

# Alarm bitti: susturma kendini sifirlar,

# yoksa sistem bir daha hic otmez.

write_command({"mute": False})

command["mute"] = False

elif edge == "rise" and cooldown_passed(command):

send_telegram(alarm_message(record, command))

write_command({"last_notified_at": now_iso()})

except Exception as e:

print("ALARM/NOTIFY ERROR:", e)

return jsonify({

"success": True,

"cmd": device_command(command)

})

except Exception as e:

print("DATABASE ERROR:", e)

return jsonify({

"success": False,

"error": str(e)

}), 500

@app.route("/api/command", methods=["GET"])

def get_command():

try:

command = read_command()

return jsonify({

"fan": truthy(command.get("fan_request")),

"mute": truthy(command.get("mute")),

"gas_threshold": command.get("gas_threshold"),

"flame_threshold": command.get("flame_threshold"),

"temp_rise": command.get("temp_rise"),

"temp_max": command.get("temp_max"),

"humidity_high": command.get("humidity_high"),

"humidity_low": command.get("humidity_low"),

"updated_at": command.get("updated_at")

})

except Exception as e:

return jsonify({"error": str(e)}), 500

@app.route("/api/command", methods=["POST"])

@require_token()

def set_command():

data = request.get_json(silent=True)

if not data:

return jsonify({

"success": False,

"error": "No JSON data"

}), 400

patch = {}

if "fan" in data:

patch["fan_request"] = truthy(data["fan"])

if "mute" in data:

patch["mute"] = truthy(data["mute"])

# Her alanin kendi gecerli araligi var; cihaza sacma esik gitmesin.

# gaz/alev analogRead sinirlari, sicaklik DHT11'in olcebildigi aralik.

for key, low, high in (

("gas_threshold", 0, 1023),

("flame_threshold", 0, 1023),

("temp_rise", 1, 30),

("temp_max", 0, TEMP_MAX_LIMIT),

("humidity_high", HUMIDITY_MIN_LIMIT + 1, HUMIDITY_MAX_LIMIT),

("humidity_low", HUMIDITY_MIN_LIMIT, HUMIDITY_MAX_LIMIT - 1)

):

if key not in data:

continue

try:

value = int(data[key])

except (TypeError, ValueError):

return jsonify({

"success": False,

"error": key + " sayi olmali"

}), 400

if not low <= value <= high:

return jsonify({

"success": False,

"error": "%s %d-%d araliginda olmali" % (key, low, high)

}), 400

patch[key] = value

if not patch:

return jsonify({

"success": False,

"error": "Degistirilecek alan yok"

}), 400

try:

write_command(patch)

return jsonify({

"success": True,

"applied": patch

})

except Exception as e:

return jsonify({

"success": False,

"error": str(e)

}), 500

@app.route("/api/latest")

def latest():

try:

response = (

supabase

.table("sensor_data")

.select("*")

.order("created_at", desc=True)

.limit(1)

.execute()

)

if response.data:

row = dict(response.data[0])

# Cihaz susarsa /api/latest son kaydi sonsuza kadar dondurur ve

# olu sistem "guvende" gorunur. Yasi da gonderiyoruz ki istemci

# bayat veriyi canli sanmasin.

row["age_seconds"] = age_seconds(row.get("created_at"))

row["stale"] = (

row["age_seconds"] is None or

row["age_seconds"] > STALE_SECONDS

)

return jsonify(row)

return jsonify({})

except Exception as e:

return jsonify({

"error": str(e)

}), 500

@app.route("/api/history")

def history():

try:

minutes = int(request.args.get("minutes", 15))

except (TypeError, ValueError):

minutes = 15

minutes = max(1, min(minutes, 1440))

since = (

datetime.now(timezone.utc) - timedelta(minutes=minutes)

).isoformat()

try:

response = (

supabase

.table("sensor_data")

.select("*")

.gte("created_at", since)

.order("created_at", desc=False)

.limit(5000)

.execute()

)

return jsonify(downsample(response.data or []))

except Exception as e:

return jsonify({

"error": str(e)

}), 500

if __name__ == "__main__":

app.run(

host="0.0.0.0",

port=int(os.environ.get("PORT", 5000))

)

## 6.4 Database schema

This creates the commands table, which has only one row and holds the wanted state, an index on the timestamp for the history queries, and a daily job that deletes records older than seven days. The cleanup is necessary because one record every five seconds is about 17000 rows a day, which would fill the free storage in a few months.

-- Supabase SQL editorunde bir kez calistirilir.

-- Uygulamanin yazdigi, cihazin okudugu istenen durum.

-- Tek satir: id her zaman 1.

create table if not exists commands (

id int primary key default 1,

fan_request boolean default false,

mute boolean default false,

gas_threshold int default 400,

flame_threshold int default 80,

last_notified_at timestamptz,

updated_at timestamptz default now(),

constraint single_row check (id = 1)

);

insert into commands (id) values (1)

on conflict (id) do nothing;

-- Sicaklik alarmi esikleri.

-- temp_rise: 60 saniyede bu kadar C yukselirse alarm (yangin imzasi).

-- temp_max: mutlak tavan. DHT11 sadece 0-50 C olcuyor, 50 uzeri

-- deger girilirse alarm hic tetiklenmez.

-- Tablo zaten kuruluysa bu satirlar eksik kolonlari ekler.

alter table commands add column if not exists temp_rise int default 5;

alter table commands add column if not exists temp_max int default 45;

-- Nem uyari sinirlari. DHT11 20-90% RH olcuyor; disinda bir esik

-- uyariyi hic tetiklenmez hale getirir.

alter table commands add column if not exists humidity_high int default 80;

alter table commands add column if not exists humidity_low int default 25;

update commands set temp_rise = coalesce(temp_rise, 5),

temp_max = coalesce(temp_max, 45),

humidity_high = coalesce(humidity_high, 80),

humidity_low = coalesce(humidity_low, 25)

where id = 1;

-- Gecmis sorgulari zaman araligiyla filtreliyor.

create index if not exists sensor_data_created_at_idx

on sensor_data (created_at desc);

-- 5 saniyede bir kayit = gunde ~17.000 satir.

-- Ucretsiz katman (500 MB) birkac ayda dolar, gunluk temizlik sart.

-- pg_cron paneldeki Database > Extensions bolumunden etkinlestirilir.

select cron.schedule(

'sensor_data_cleanup',

'0 3 * * *',

$$delete from sensor_data where created_at < now() - interval '7 days'$$

);

-- pg_cron etkinlestirilemezse yukaridaki satiri atla ve bunu ara sira elle calistir:

-- delete from sensor_data where created_at < now() - interval '7 days';

## 6.5 Web page

The web page shows the live values, the controls, a chart with four lines and selectable time ranges, a second chart for the alarm and fan history, an alarm list and a history table. The access key is typed once and kept in the browser instead of being written in the page. The chart is resized after it is created, because it can be built before the page layout is finished. When that happens the container has zero width and the chart never appears.

<!DOCTYPE html>

<html lang="tr">

<head>

<meta charset="UTF-8">

<meta name="viewport" content="width=device-width, initial-scale=1.0">

<title>Smart Safety System</title>

<script src="https://cdn.jsdelivr.net/npm/chart.js@4.4.1/dist/chart.umd.min.js"></script>

<style>

body {

font-family: Arial, sans-serif;

background: #f4f4f4;

margin: 0;

padding: 20px;

text-align: center;

}

h1 { margin-bottom: 15px; }

h2 { margin-top: 30px; }

.container {

max-width: 900px;

margin: auto;

}

.grid {

display: grid;

grid-template-columns: repeat(auto-fit, minmax(140px, 1fr));

gap: 15px;

}

.card, .panel, .chartBox {

background: white;

border-radius: 12px;

box-shadow: 0 2px 8px rgba(0,0,0,0.1);

}

.card { padding: 20px; }

.card h3 {

margin: 0;

font-size: 14px;

color: #666;

font-weight: normal;

}

.value {

font-size: 28px;

font-weight: bold;

margin-top: 10px;

}

.normal { color: green; }

.danger { color: red; }

.note {

font-size: 13px;

font-weight: bold;

margin-top: 6px;

min-height: 16px;

color: #b45309;

}

#lastUpdate {

margin: 20px;

color: #666;

font-size: 14px;

}

.panel {

padding: 20px;

margin-top: 15px;

}

button {

font-size: 16px;

padding: 12px 18px;

border: none;

border-radius: 10px;

background: #e5e7eb;

color: #111827;

cursor: pointer;

margin: 4px;

}

button.on {

background: #ef4444;

color: white;

}

button:disabled {

opacity: 0.5;

cursor: not-allowed;

}

.hint {

color: #b45309;

font-size: 13px;

min-height: 18px;

margin-top: 8px;

}

.row {

display: flex;

flex-wrap: wrap;

justify-content: center;

align-items: center;

gap: 10px;

}

input[type=number] {

font-size: 16px;

padding: 10px;

width: 90px;

border: 1px solid #ccc;

border-radius: 8px;

}

label { font-size: 14px; color: #444; }

.banner.stale {

background: #fee2e2;

border-color: #ef4444;

font-weight: bold;

}

.stale .value, .staleValues .value {

opacity: 0.45;

}

.banner {

background: #fef3c7;

border: 1px solid #f59e0b;

padding: 12px;

border-radius: 10px;

margin-bottom: 15px;

font-size: 14px;

}

.chartBox {

position: relative;

height: 300px;

padding: 15px;

}

.tabs button { padding: 8px 14px; font-size: 14px; }

button.small {

padding: 6px 12px;

font-size: 13px;

}

#tokenState {

font-size: 13px;

color: #444;

}

.logList {

margin-top: 8px;

font-size: 13px;

max-height: 160px;

overflow-y: auto;

}

.logList div {

padding: 4px 0;

border-bottom: 1px solid #eee;

}

.tabs button.active {

background: #111827;

color: white;

}

table {

width: 100%;

margin-top: 15px;

border-collapse: collapse;

background: white;

font-size: 13px;

}

th, td { padding: 8px; border: 1px solid #ddd; }

th { background: #eee; }

.tableWrap { overflow-x: auto; }

</style>

</head>

<body>

<div class="container">

<h1>Smart Safety System</h1>

<div id="staleBanner" class="banner stale" style="display:none"></div>

<div id="tokenBanner" class="banner" style="display:none">

Kontrol için erişim anahtarı gerekli.

<button onclick="askToken()">Anahtar gir</button>

</div>

<div class="grid">

<div class="card"><h3>Sıcaklık</h3><div id="temperature" class="value">--</div></div>

<div class="card">

<h3>Nem</h3>

<div id="humidity" class="value">--</div>

<div id="humidityNote" class="note"></div>

</div>

<div class="card"><h3>Gaz</h3><div id="gas" class="value">--</div></div>

<div class="card"><h3>Alev</h3><div id="flame" class="value">--</div></div>

<div class="card"><h3>Fan</h3><div id="fan" class="value">--</div></div>

<div class="card"><h3>Alarm</h3><div id="alarm" class="value">--</div></div>

</div>

<div id="lastUpdate">Son güncelleme: --</div>

<h2>Kontrol</h2>

<div class="panel">

<div class="row">

<button id="fanBtn" onclick="toggleFan()">Fan</button>

<button id="muteBtn" onclick="toggleMute()">Sesi kes</button>

</div>

<div id="controlHint" class="hint"></div>

<div class="row" style="margin-top:15px">

<label>Gaz eşiği

<input id="gasThreshold" type="number" min="0" max="1023">

</label>

<label>Alev eşiği

<input id="flameThreshold" type="number" min="0" max="1023">

</label>

<label title="60 saniyede bu kadar °C yükselirse alarm">Isınma °C/dk

<input id="tempRise" type="number" min="1" max="30">

</label>

<label title="DHT11 en fazla 50 °C ölçebiliyor">Sıcaklık tavanı

<input id="tempMax" type="number" min="0" max="50">

</label>

<label title="DHT11 nemi 20-90% aralığında ölçüyor">Nem üst

<input id="humidityHigh" type="number" min="21" max="90">

</label>

<label title="DHT11 nemi 20-90% aralığında ölçüyor">Nem alt

<input id="humidityLow" type="number" min="20" max="89">

</label>

<button id="saveBtn" onclick="saveThresholds()">Kaydet</button>

</div>

<div id="thresholdMsg" class="hint"></div>

<div class="row" style="margin-top:15px">

<span id="tokenState" class="small"></span>

<button class="small" onclick="askToken()">Anahtarı değiştir</button>

<button class="small" onclick="clearToken()">Anahtarı sil</button>

</div>

</div>

<h2>Grafik</h2>

<div class="row tabs" id="windowTabs">

<button data-minutes="1" onclick="setWindow(1)">1 dk</button>

<button data-minutes="5" onclick="setWindow(5)">5 dk</button>

<button data-minutes="15" onclick="setWindow(15)">15 dk</button>

<button data-minutes="60" onclick="setWindow(60)">1 saat</button>

</div>

<div class="chartBox" style="margin-top:10px">

<canvas id="chart"></canvas>

</div>

<h2>Alarm ve fan geçmişi</h2>

<div class="chartBox" style="margin-top:10px">

<canvas id="alarmChart"></canvas>

</div>

<div class="panel" style="text-align:left">

<strong>Alarm başlangıçları</strong>

<div id="alarmLog" class="logList"></div>

</div>

<h2>Geçmiş</h2>

<div class="tableWrap">

<table>

<thead>

<tr>

<th>Zaman</th><th>Sıcaklık</th><th>Nem</th>

<th>Gaz</th><th>Alev</th><th>Fan</th><th>Alarm</th>

</tr>

</thead>

<tbody id="history"></tbody>

</table>

</div>

</div>

<script>

const TOKEN_KEY = "sss_token";

// Nem uyari sinirlari sunucudan geliyor (commands tablosu).

// Sunucu okunamazsa bunlar kullanilir; DHT11 20-90% RH olcuyor.

const HUMIDITY_HIGH_FALLBACK = 80;

const HUMIDITY_LOW_FALLBACK = 25;

let windowMinutes = 15;

let chart = null;

let alarmChart = null;

let deviceFan = null;

let desired = null;

function getToken() {

return localStorage.getItem(TOKEN_KEY) || "";

}

function askToken() {

const value = prompt("Erişim anahtarı (Render'daki API_TOKEN):", getToken());

if (value !== null) {

localStorage.setItem(TOKEN_KEY, value.trim());

updateTokenBanner();

loadCommand();

}

}

function clearToken() {

localStorage.removeItem(TOKEN_KEY);

updateTokenBanner();

}

function updateTokenBanner() {

const token = getToken();

const missing = !token;

document.getElementById("tokenBanner").style.display = missing ? "block" : "none";

["fanBtn", "muteBtn", "saveBtn"].forEach(id => {

document.getElementById(id).disabled = missing;

});

// Anahtarin tamamini gostermiyoruz; girilip girilmedigi yeterli.

document.getElementById("tokenState").innerText =

missing

? "Anahtar girilmedi"

: "Anahtar: " + token.slice(0, 4) + "…" + token.slice(-4);

}

async function postCommand(patch) {

if (!getToken()) {

askToken();

return null;

}

try {

const response = await fetch("/api/command", {

method: "POST",

headers: {

"Content-Type": "application/json",

"X-Auth": getToken()

},

body: JSON.stringify(patch)

});

if (response.status === 401) {

localStorage.removeItem(TOKEN_KEY);

updateTokenBanner();

alert("Anahtar geçersiz, tekrar gir.");

return null;

}

const data = await response.json();

if (!response.ok) {

alert("Hata: " + (data.error || response.status));

return null;

}

await loadCommand();

return data;

} catch (error) {

console.error(error);

alert("Sunucuya ulaşılamadı.");

return null;

}

}

async function loadCommand() {

try {

const data = await (await fetch("/api/command")).json();

if (data.error) return;

desired = data;

const fanBtn = document.getElementById("fanBtn");

fanBtn.className = data.fan ? "on" : "";

fanBtn.innerText = data.fan ? "Fan: AÇIK" : "Fan: KAPALI";

const muteBtn = document.getElementById("muteBtn");

muteBtn.className = data.mute ? "on" : "";

muteBtn.innerText = data.mute ? "Ses: KAPALI" : "Sesi kes";

const gasInput = document.getElementById("gasThreshold");

const flameInput = document.getElementById("flameThreshold");

if (document.activeElement !== gasInput) gasInput.value = data.gas_threshold;

if (document.activeElement !== flameInput) flameInput.value = data.flame_threshold;

const riseInput = document.getElementById("tempRise");

const maxInput = document.getElementById("tempMax");

if (document.activeElement !== riseInput) riseInput.value = data.temp_rise;

if (document.activeElement !== maxInput) maxInput.value = data.temp_max;

const humHighInput = document.getElementById("humidityHigh");

const humLowInput = document.getElementById("humidityLow");

if (document.activeElement !== humHighInput) humHighInput.value = data.humidity_high;

if (document.activeElement !== humLowInput) humLowInput.value = data.humidity_low;

updateHint();

} catch (error) {

console.error(error);

}

}

function updateHint() {

// Komut cihaza ~5 saniyede iniyor. Iyimser gosterim yok:

// istenen ile cihazin bildirdigi ayni olana kadar "bekliyor".

const box = document.getElementById("controlHint");

if (desired === null || deviceFan === null) {

box.innerText = "";

return;

}

box.innerText =

(Boolean(desired.fan) && !deviceFan)

? "Fan komutu cihaza gönderiliyor..."

: "";

}

function toggleFan() {

postCommand({ fan: desired && desired.fan ? 0 : 1 });

}

function toggleMute() {

postCommand({ mute: desired && desired.mute ? 0 : 1 });

}

async function saveThresholds() {

const message = document.getElementById("thresholdMsg");

const result = await postCommand({

gas_threshold: Number(document.getElementById("gasThreshold").value),

flame_threshold: Number(document.getElementById("flameThreshold").value),

temp_rise: Number(document.getElementById("tempRise").value),

temp_max: Number(document.getElementById("tempMax").value),

humidity_high: Number(document.getElementById("humidityHigh").value),

humidity_low: Number(document.getElementById("humidityLow").value)

});

if (result) {

message.innerText = "Kaydedildi, cihaza iniyor...";

setTimeout(() => { message.innerText = ""; }, 4000);

}

}

function ageText(seconds) {

if (seconds === null || seconds === undefined) return "zamanı bilinmiyor";

if (seconds < 90) return seconds + " sn önce";

if (seconds < 5400) return Math.round(seconds / 60) + " dk önce";

return Math.round(seconds / 3600) + " saat önce";

}

function showStale(data) {

// Cihaz susarsa /api/latest son kaydi sonsuza kadar dondurur.

// Yasini sunucu hesapliyor: tarayicinin saati kaymissa yanilmayalim.

const banner = document.getElementById("staleBanner");

const stale = Boolean(data.stale);

banner.style.display = stale ? "block" : "none";

if (stale) {

banner.innerText =

"VERİ AKIŞI DURDU — son kayıt " + ageText(data.age_seconds) +

". Aşağıdaki değerler güncel değil, sistem şu anda izlenmiyor.";

}

document.querySelector(".grid").className = stale ? "grid staleValues" : "grid";

}

const show = (value, suffix) =>

(value === null || value === undefined) ? "--" : value + suffix;

async function loadLatest() {

try {

const data = await (await fetch("/api/latest")).json();

if (!data || !data.id) return;

document.getElementById("temperature").innerText = show(data.temperature, " °C");

document.getElementById("humidity").innerText = show(data.humidity, " %");

const note = document.getElementById("humidityNote");

const wet = data.humidity;

if (wet === null || wet === undefined) {

note.innerText = "";

} else if (wet >= (desired ? desired.humidity_high : HUMIDITY_HIGH_FALLBACK)) {

note.innerText = "ÇOK NEMLİ";

} else if (wet <= (desired ? desired.humidity_low : HUMIDITY_LOW_FALLBACK)) {

note.innerText = "ÇOK KURU";

} else {

note.innerText = "";

}

document.getElementById("gas").innerText = show(data.gas, "");

document.getElementById("flame").innerText = show(data.flame, "");

deviceFan = Boolean(data.fan);

document.getElementById("fan").innerText = data.fan ? "AÇIK" : "KAPALI";

const alarmBox = document.getElementById("alarm");

// Veri bayatsa alarm durumu artik gecerli degil: "NORMAL" yazmak

// olu sistemi guvenli gostermek olur.

if (data.stale) {

alarmBox.innerText = "BİLİNMİYOR";

alarmBox.className = "value";

} else {

alarmBox.innerText = data.alarm ? "ALARM" : "NORMAL";

alarmBox.className = data.alarm ? "value danger" : "value normal";

}

document.getElementById("lastUpdate").innerText =

"Son güncelleme: " + new Date(data.created_at).toLocaleString();

showStale(data);

updateHint();

} catch (error) {

console.error(error);

}

}

function setWindow(minutes) {

windowMinutes = minutes;

document.querySelectorAll("#windowTabs button").forEach(button => {

button.className = Number(button.dataset.minutes) === minutes ? "active" : "";

});

loadHistory();

}

/**

* Chart.js kapsayiciyi olcup canvas'i ona gore boyutlandiriyor. Grafik

* sayfa yerlesimi tamamlanmadan olusursa 0 genislik olculuyor ve kendi

* ResizeObserver'i "boyut degismedi" diye bir daha tetiklenmiyor --

* grafik hic gorunmuyor.

*

* requestAnimationFrame yetmiyor: sayfa arka planda veya gorunmezken

* kare cizilmedigi icin geri cagri hic calismayabiliyor. Bu yuzden hem

* kendi ResizeObserver'imizi takiyoruz hem de her veri yenilemesinde

* yeniden olcturuyoruz (boyut degismediyse Chart.js zaten islem yapmaz).

*/

function resizeChart(instance, canvasId) {

const box = document.getElementById(canvasId).parentElement;

// offsetWidth okumak yerlesimi senkron hesaplatir. Bu olmadan

// Chart.js kapsayiciyi olcerken 0 gorebiliyor -- yerlesim henuz

// hesaplanmamissa veya sayfa kare cizmiyorsa (arka plan sekmesi).

void box.offsetWidth;

instance.resize();

}

function keepSized(instance, canvasId) {

resizeChart(instance, canvasId);

// Zamanlayici, kare cizimine bagli degil: requestAnimationFrame ve

// ResizeObserver sayfa gorunmezken hic tetiklenmeyebiliyor.

setTimeout(() => resizeChart(instance, canvasId), 150);

if (typeof ResizeObserver === "undefined") return;

// Pencere yeniden boyutlandirilinca da uysun.

new ResizeObserver(() => resizeChart(instance, canvasId))

.observe(document.getElementById(canvasId).parentElement);

}

function drawChart(rows) {

if (typeof Chart === "undefined") return;

const labels = rows.map(row => new Date(row.created_at).toLocaleTimeString());

const series = key => rows.map(row => row[key]);

const datasets = [

{ label: "Sıcaklık", data: series("temperature"), borderColor: "#ef4444", yAxisID: "y" },

{ label: "Nem", data: series("humidity"), borderColor: "#3b82f6", yAxisID: "y" },

{ label: "Gaz", data: series("gas"), borderColor: "#f59e0b", yAxisID: "y1" },

{ label: "Alev", data: series("flame"), borderColor: "#10b981", yAxisID: "y1" }

];

datasets.forEach(set => {

set.borderWidth = 2;

set.tension = 0.25;

set.spanGaps = true;

});

if (chart) {

chart.data.labels = labels;

chart.data.datasets.forEach((set, i) => { set.data = datasets[i].data; });

resizeChart(chart, "chart");

chart.update("none");

return;

}

// Sicaklik/nem 0-100, gaz/alev 0-1023. Tek eksende sicaklik gorunmez olur.

const scales = {

y: { position: "left", suggestedMin: 0, suggestedMax: 100 },

y1: {

position: "right",

suggestedMin: 0,

suggestedMax: 1023,

grid: { drawOnChartArea: false }

},

x: { ticks: { maxTicksLimit: 6 } }

};

chart = new Chart(document.getElementById("chart"), {

type: "line",

data: { labels: labels, datasets: datasets },

options: {

responsive: true,

maintainAspectRatio: false,

animation: false,

elements: { point: { radius: 0 } },

interaction: { mode: "index", intersect: false },

scales: scales

}

});

// Grafik, sayfa yerlesimi tamamlanmadan olusabiliyor; o anda kapsayici

// 0 genislikte olculuyor ve Chart.js'in ResizeObserver'i boyut

// "degismedigi" icin bir daha tetiklenmiyor -- grafik hic gorunmuyor.

// Yerlesim kesinlestikten sonra bir kez daha olcturuyoruz.

keepSized(chart, "chart");

}

/**

* Alarmin sebebi veritabaninda tutulmuyor, sadece alarm biti var.

* Kayitli gaz/alev degerlerini guncel esiklerle karsilastirip cikariyoruz.

*

* Sinirlamasi: esikler sonradan degistirildiyse eski kayitlarin sebebi

* yeni esige gore hesaplanir. Cihazdaki kural birebir ayni.

*/

function alarmCause(row, rows, index) {

const gasLimit = desired ? desired.gas_threshold : 400;

const flameLimit = desired ? desired.flame_threshold : 80;

const riseLimit = desired ? desired.temp_rise : 5;

const maxLimit = desired ? desired.temp_max : 45;

const temp = row.temperature;

const has = v => v !== null && v !== undefined;

// Cihaz 60 saniyelik pencereye bakiyor; burada da ayni pencere,

// gecmis dizisinde 60 saniye onceki kayit aranarak bulunuyor.

let rise = false;

if (has(temp) && Array.isArray(rows) && index > 0) {

const now = new Date(row.created_at).getTime();

for (let i = index - 1; i >= 0; i--) {

const past = new Date(rows[i].created_at).getTime();

if (now - past >= 60000) {

rise = has(rows[i].temperature) &&

(temp - rows[i].temperature) >= riseLimit;

break;

}

}

}

return {

gas: has(row.gas) && row.gas >= gasLimit,

flame: has(row.flame) && row.flame <= flameLimit,

tempMax: has(temp) && temp >= maxLimit,

tempRise: rise

};

}

function drawAlarmChart(rows) {

if (typeof Chart === "undefined") return;

const labels = rows.map(row => new Date(row.created_at).toLocaleTimeString());

// Ucu de 0/1. Tam ust uste cizilirse biri digerini tamamen gizler,

// bu yuzden her seri biraz farkli yukseklikte duruyor.

const datasets = [

{

label: "Gaz alarmı",

data: rows.map((row, i) => alarmCause(row, rows, i).gas ? 1 : 0),

borderColor: "#f59e0b",

backgroundColor: "rgba(245,158,11,0.25)"

},

{

label: "Alev alarmı",

data: rows.map((row, i) => alarmCause(row, rows, i).flame ? 0.92 : 0),

borderColor: "#ef4444",

backgroundColor: "rgba(239,68,68,0.25)"

},

{

label: "Sıcaklık alarmı",

data: rows.map((row, i) => {

const c = alarmCause(row, rows, i);

return (c.tempMax || c.tempRise) ? 0.84 : 0;

}),

borderColor: "#8b5cf6",

backgroundColor: "rgba(139,92,246,0.25)"

},

{

label: "Fan",

data: rows.map(row => row.fan ? 0.76 : 0),

borderColor: "#3b82f6",

backgroundColor: "rgba(59,130,246,0.15)"

}

];

// Basamak cizgisi: 0/1 degerleri egimli cizilirse olmayan

// ara durumlar varmis gibi gorunur.

datasets.forEach(set => {

set.stepped = true;

set.fill = true;

set.borderWidth = 2;

set.pointRadius = 0;

});

if (alarmChart) {

alarmChart.data.labels = labels;

alarmChart.data.datasets.forEach((set, i) => { set.data = datasets[i].data; });

resizeChart(alarmChart, "alarmChart");

alarmChart.update("none");

return;

}

const scales = {

y: {

min: -0.1,

max: 1.1,

ticks: {

stepSize: 1,

callback: value => value === 1 ? "VAR" : (value === 0 ? "YOK" : "")

}

},

x: { ticks: { maxTicksLimit: 6 } }

};

alarmChart = new Chart(document.getElementById("alarmChart"), {

type: "line",

data: { labels: labels, datasets: datasets },

options: {

responsive: true,

maintainAspectRatio: false,

animation: false,

interaction: { mode: "index", intersect: false },

scales: scales

}

});

keepSized(alarmChart, "alarmChart");

}

function fillAlarmLog(rows) {

const box = document.getElementById("alarmLog");

// Sadece 0 -> 1 gecisleri. Alarm suresince her satiri listelemek

// tek bir olayi yuzlerce satir gibi gosterirdi.

const events = [];

let previous = false;

rows.forEach((row, index) => {

const now = Boolean(row.alarm);

if (now && !previous) {

const cause = alarmCause(row, rows, index);

const reasons = [];

if (cause.gas) reasons.push("Gaz " + row.gas);

if (cause.flame) reasons.push("Alev " + row.flame);

if (cause.tempMax) reasons.push("Sıcaklık " + row.temperature + "°C");

if (cause.tempRise) reasons.push("Hızlı ısınma (" + row.temperature + "°C)");

events.push(

new Date(row.created_at).toLocaleString() +

" — " +

(reasons.length ? reasons.join(" + ") : "sebep eşiklerden çıkarılamadı")

);

}

previous = now;

});

box.innerHTML = events.length

? events.slice(-20).reverse().map(t => "<div>" + t + "</div>").join("")

: "<div>Bu aralıkta alarm yok</div>";

}

function fillTable(rows) {

const table = document.getElementById("history");

table.innerHTML = "";

const cell = value => (value === null || value === undefined) ? "--" : value;

rows.slice().reverse().slice(0, 50).forEach(row => {

const tr = document.createElement("tr");

tr.innerHTML =

"<td>" + new Date(row.created_at).toLocaleTimeString() + "</td>" +

"<td>" + cell(row.temperature) + "</td>" +

"<td>" + cell(row.humidity) + "</td>" +

"<td>" + cell(row.gas) + "</td>" +

"<td>" + cell(row.flame) + "</td>" +

"<td>" + (row.fan ? "AÇIK" : "KAPALI") + "</td>" +

"<td>" + (row.alarm ? "ALARM" : "NORMAL") + "</td>";

table.appendChild(tr);

});

}

async function loadHistory() {

try {

const rows = await (await fetch("/api/history?minutes=" + windowMinutes)).json();

if (!Array.isArray(rows)) return;

drawChart(rows);

drawAlarmChart(rows);

fillAlarmLog(rows);

fillTable(rows);

} catch (error) {

console.error(error);

}

}

function refresh() {

loadLatest();

loadCommand();

}

updateTokenBanner();

setWindow(15);

refresh();

setInterval(refresh, 3000);

setInterval(loadHistory, 10000);

</script>

</body>

</html>

## 6.6 Android application

The app is written in Kotlin with Jetpack Compose and is made of six files. MainActivity.kt draws the screen. It asks the server for the live values and the command state, holds the fan, mute and threshold controls, and draws the chart. If the server says the last reading is old, the screen stops showing NORMAL and shows a warning instead. MonitorService.kt is the part that keeps working when the app is closed. It checks the server every ten seconds and builds the alarm notification itself, so I did not need Firebase or any push service. The notification only appears when the alarm starts, not again while it continues, and losing the connection uses a separate and quieter channel, so a Wi-Fi problem at night does not wake anyone up with an alarm sound.

Api.kt has all the network code. It uses HttpURLConnection and the org.json parser that Android already has, so the app needs no networking library, and its date parser accepts the different formats the database can return. Chart.kt draws the chart on a Compose canvas instead of using a chart library. Temperature and humidity are on a 0 to 100 scale and gas and flame on 0 to 1023, because with one shared scale the temperature line is squashed at the bottom and cannot be seen, and a missing reading cuts the line instead of being guessed. Settings.kt keeps the server address and the access key on the phone, never inside the app, and BootReceiver.kt starts the monitoring again after the phone is restarted so it does not stop without me noticing.

MainActivity.kt, the screen

package com.egegurtunca.smartsafety

import android.Manifest

import android.content.pm.PackageManager

import android.os.Build

import android.os.Bundle

import androidx.activity.ComponentActivity

import androidx.activity.compose.setContent

import androidx.activity.result.contract.ActivityResultContracts

import androidx.compose.foundation.layout.Arrangement

import androidx.compose.foundation.layout.Column

import androidx.compose.foundation.layout.Row

import androidx.compose.foundation.layout.fillMaxSize

import androidx.compose.foundation.layout.fillMaxWidth

import androidx.compose.foundation.layout.padding

import androidx.compose.foundation.rememberScrollState

import androidx.compose.foundation.text.KeyboardOptions

import androidx.compose.foundation.verticalScroll

import androidx.compose.material3.Button

import androidx.compose.material3.ButtonDefaults

import androidx.compose.material3.Card

import androidx.compose.material3.CardDefaults

import androidx.compose.material3.FilterChip

import androidx.compose.material3.MaterialTheme

import androidx.compose.material3.OutlinedTextField

import androidx.compose.material3.Switch

import androidx.compose.material3.Text

import androidx.compose.material3.darkColorScheme

import androidx.compose.runtime.Composable

import androidx.compose.runtime.LaunchedEffect

import androidx.compose.runtime.getValue

import androidx.compose.runtime.mutableStateOf

import androidx.compose.runtime.remember

import androidx.compose.runtime.setValue

import androidx.compose.ui.Alignment

import androidx.compose.ui.Modifier

import androidx.compose.ui.graphics.Color

import androidx.compose.ui.platform.LocalContext

import androidx.compose.ui.text.font.FontWeight

import androidx.compose.ui.text.input.KeyboardType

import androidx.compose.ui.unit.dp

import androidx.core.content.ContextCompat

import kotlinx.coroutines.Dispatchers

import kotlinx.coroutines.delay

import kotlinx.coroutines.launch

import kotlinx.coroutines.withContext

import org.json.JSONObject

private val DANGER = Color(0xFFEF4444)

private val SAFE = Color(0xFF10B981)

private val WARN = Color(0xFFF59E0B)

// Nem uyari sinirlari sunucudan geliyor; bunlar sadece sunucu

// okunamadiginda kullanilan yedek degerler.

private const val HUMIDITY_HIGH_FALLBACK = 80.0

private const val HUMIDITY_LOW_FALLBACK = 25.0

class MainActivity : ComponentActivity() {

override fun onCreate(savedInstanceState: Bundle?) {

super.onCreate(savedInstanceState)

askNotificationPermission()

setContent {

MaterialTheme(colorScheme = darkColorScheme()) {

AppScreen()

}

}

}

private fun askNotificationPermission() {

if (Build.VERSION.SDK_INT < Build.VERSION_CODES.TIRAMISU) {

return

}

val granted = ContextCompat.checkSelfPermission(

this, Manifest.permission.POST_NOTIFICATIONS

) == PackageManager.PERMISSION_GRANTED

if (granted) {

return

}

registerForActivityResult(ActivityResultContracts.RequestPermission()) { }

.launch(Manifest.permission.POST_NOTIFICATIONS)

}

}

@Composable

fun AppScreen() {

val context = LocalContext.current

val scope = rememberCoroutineScopeCompat()

var config by remember { mutableStateOf(Settings.load(context)) }

var reading by remember { mutableStateOf<Reading?>(null) }

var command by remember { mutableStateOf<Command?>(null) }

var history by remember { mutableStateOf<List<Reading>>(emptyList()) }

var minutes by remember { mutableStateOf(15) }

var message by remember { mutableStateOf("") }

var gasField by remember { mutableStateOf("") }

var flameField by remember { mutableStateOf("") }

var riseField by remember { mutableStateOf("") }

var maxField by remember { mutableStateOf("") }

var humHighField by remember { mutableStateOf("") }

var humLowField by remember { mutableStateOf("") }

var fieldsFilled by remember { mutableStateOf(false) }

// Canli degerler ve komut durumu

LaunchedEffect(config.baseUrl) {

while (true) {

if (config.canMonitor) {

withContext(Dispatchers.IO) {

when (val result = Api.latest(config)) {

is ApiResult.Ok -> {

reading = result.value

message = ""

}

is ApiResult.Fail -> message = result.message

}

when (val result = Api.command(config)) {

is ApiResult.Ok -> command = result.value

is ApiResult.Fail -> Unit

}

}

command?.let {

if (!fieldsFilled) {

gasField = it.gasThreshold.toString()

flameField = it.flameThreshold.toString()

riseField = it.tempRise.toString()

maxField = it.tempMax.toString()

humHighField = it.humidityHigh.toString()

humLowField = it.humidityLow.toString()

fieldsFilled = true

}

}

}

delay(3000)

}

}

// Gecmis / grafik

LaunchedEffect(config.baseUrl, minutes) {

while (true) {

if (config.canMonitor) {

withContext(Dispatchers.IO) {

when (val result = Api.history(config, minutes)) {

is ApiResult.Ok -> history = result.value

is ApiResult.Fail -> Unit

}

}

}

delay(10_000)

}

}

// Izleme servisi

LaunchedEffect(config.canMonitor, config.monitorEnabled) {

if (config.canMonitor && config.monitorEnabled) {

MonitorService.start(context)

} else {

MonitorService.stop(context)

}

}

fun send(patch: JSONObject, okText: String) {

scope.launch {

val result = withContext(Dispatchers.IO) { Api.sendCommand(config, patch) }

message = when (result) {

is ApiResult.Ok -> okText

is ApiResult.Fail -> result.message

}

withContext(Dispatchers.IO) {

(Api.command(config) as? ApiResult.Ok)?.let { command = it.value }

}

}

}

Column(

modifier = Modifier

.fillMaxSize()

.verticalScroll(rememberScrollState())

.padding(16.dp),

verticalArrangement = Arrangement.spacedBy(12.dp)

) {

Text(

text = "Smart Safety System",

style = MaterialTheme.typography.headlineSmall,

fontWeight = FontWeight.Bold

)

if (message.isNotBlank()) {

Text(text = message, color = DANGER, style = MaterialTheme.typography.bodySmall)

}

// -------------------------------------------------------------

// Canli degerler

// -------------------------------------------------------------

val stale = reading?.stale == true

val alarmOn = reading?.alarm == true && !stale

Card(

colors = CardDefaults.cardColors(

containerColor = when {

stale -> WARN.copy(alpha = 0.25f)

alarmOn -> DANGER.copy(alpha = 0.25f)

else -> MaterialTheme.colorScheme.surfaceVariant

}

)

) {

Column(Modifier.padding(16.dp)) {

// Veri bayatsa alarm durumu artik gecerli degil:

// "NORMAL" yazmak olu sistemi guvenli gostermek olur.

Text(

text = when {

stale -> "VERİ AKIŞI DURDU"

alarmOn -> "ALARM"

else -> "NORMAL"

},

style = MaterialTheme.typography.headlineMedium,

fontWeight = FontWeight.Bold,

color = when {

stale -> WARN

alarmOn -> DANGER

else -> SAFE

}

)

Text(

text =

if (stale) "Son kayıt " + ageText(reading?.ageSeconds) +

" — gösterilen değerler güncel değil"

else "Fan: " + if (reading?.fan == true) "AÇIK" else "KAPALI",

style = MaterialTheme.typography.bodyMedium

)

}

}

Row(

Modifier.fillMaxWidth(),

horizontalArrangement = Arrangement.spacedBy(12.dp)

) {

ValueCard("Gaz", reading?.gas?.toString(), Modifier.weight(1f))

ValueCard("Alev", reading?.flame?.toString(), Modifier.weight(1f))

}

Row(

Modifier.fillMaxWidth(),

horizontalArrangement = Arrangement.spacedBy(12.dp)

) {

ValueCard(

"Sıcaklık",

reading?.temperature?.let { String.format("%.1f °C", it) },

Modifier.weight(1f)

)

ValueCard(

"Nem",

reading?.humidity?.let { String.format("%.0f %%", it) },

Modifier.weight(1f),

note = humidityNote(reading?.humidity, command)

)

}

// -------------------------------------------------------------

// Kontrol

// -------------------------------------------------------------

Card {

Column(Modifier.padding(16.dp), verticalArrangement = Arrangement.spacedBy(10.dp)) {

Text("Kontrol", fontWeight = FontWeight.Bold)

if (!config.canControl) {

Text(

"Erişim anahtarı girilmedi — aşağıdaki ayarlardan ekle.",

style = MaterialTheme.typography.bodySmall

)

}

Row(horizontalArrangement = Arrangement.spacedBy(10.dp)) {

Button(

onClick = {

val next = if (command?.fan == true) 0 else 1

send(JSONObject().put("fan", next), "Fan komutu gönderildi")

},

enabled = config.canControl,

colors = ButtonDefaults.buttonColors(

containerColor =

if (command?.fan == true) DANGER

else MaterialTheme.colorScheme.secondaryContainer

)

) {

Text(if (command?.fan == true) "Fan: AÇIK" else "Fan: KAPALI")

}

Button(

onClick = {

val next = if (command?.mute == true) 0 else 1

send(JSONObject().put("mute", next), "Susturma gönderildi")

},

enabled = config.canControl,

colors = ButtonDefaults.buttonColors(

containerColor =

if (command?.mute == true) DANGER

else MaterialTheme.colorScheme.secondaryContainer

)

) {

Text(if (command?.mute == true) "Ses: KAPALI" else "Sesi kes")

}

}

// Komut cihaza ~5 saniyede iniyor; iyimser gosterim yok.

if (command?.fan == true && reading?.fan == false) {

Text(

"Fan komutu cihaza gönderiliyor...",

style = MaterialTheme.typography.bodySmall

)

}

Row(

horizontalArrangement = Arrangement.spacedBy(10.dp),

verticalAlignment = Alignment.CenterVertically

) {

OutlinedTextField(

value = gasField,

onValueChange = { gasField = it },

label = { Text("Gaz eşiği") },

singleLine = true,

keyboardOptions = KeyboardOptions(keyboardType = KeyboardType.Number),

modifier = Modifier.weight(1f)

)

OutlinedTextField(

value = flameField,

onValueChange = { flameField = it },

label = { Text("Alev eşiği") },

singleLine = true,

keyboardOptions = KeyboardOptions(keyboardType = KeyboardType.Number),

modifier = Modifier.weight(1f)

)

}

Row(

horizontalArrangement = Arrangement.spacedBy(10.dp),

verticalAlignment = Alignment.CenterVertically

) {

OutlinedTextField(

value = riseField,

onValueChange = { riseField = it },

label = { Text("Isınma °C/dk") },

singleLine = true,

keyboardOptions = KeyboardOptions(keyboardType = KeyboardType.Number),

modifier = Modifier.weight(1f)

)

OutlinedTextField(

value = maxField,

onValueChange = { maxField = it },

label = { Text("Sıcaklık tavanı") },

singleLine = true,

keyboardOptions = KeyboardOptions(keyboardType = KeyboardType.Number),

modifier = Modifier.weight(1f)

)

}

Row(

horizontalArrangement = Arrangement.spacedBy(10.dp),

verticalAlignment = Alignment.CenterVertically

) {

OutlinedTextField(

value = humHighField,

onValueChange = { humHighField = it },

label = { Text("Nem üst %") },

singleLine = true,

keyboardOptions = KeyboardOptions(keyboardType = KeyboardType.Number),

modifier = Modifier.weight(1f)

)

OutlinedTextField(

value = humLowField,

onValueChange = { humLowField = it },

label = { Text("Nem alt %") },

singleLine = true,

keyboardOptions = KeyboardOptions(keyboardType = KeyboardType.Number),

modifier = Modifier.weight(1f)

)

}

Button(

onClick = {

val gas = gasField.toIntOrNull()

val flame = flameField.toIntOrNull()

val rise = riseField.toIntOrNull()

val ceiling = maxField.toIntOrNull()

if (gas == null || flame == null ||

gas !in 0..Api.SENSOR_MAX || flame !in 0..Api.SENSOR_MAX

) {

message =

"Gaz ve alev eşiği 0-${Api.SENSOR_MAX} arasında olmalı"

} else if (rise == null ||

rise !in Api.TEMP_RISE_MIN..Api.TEMP_RISE_MAX

) {

message =

"Isınma ${Api.TEMP_RISE_MIN}-${Api.TEMP_RISE_MAX} °C/dk olmalı"

} else if (

humHighField.toIntOrNull() == null ||

humLowField.toIntOrNull() == null ||

humHighField.toInt() !in (Api.HUMIDITY_MIN + 1)..Api.HUMIDITY_MAX ||

humLowField.toInt() !in Api.HUMIDITY_MIN..(Api.HUMIDITY_MAX - 1) ||

humHighField.toInt() <= humLowField.toInt()

) {

// DHT11 20-90% disini olcemiyor; ust > alt olmali.

message =

"Nem sınırları ${Api.HUMIDITY_MIN}-${Api.HUMIDITY_MAX} arasında ve üst > alt olmalı"

} else if (ceiling == null || ceiling !in 0..Api.TEMP_MAX_LIMIT) {

// DHT11 50 C ustunu olcemiyor; daha yuksek tavan hic tetiklenmez.

message = "Sıcaklık tavanı 0-${Api.TEMP_MAX_LIMIT} °C olmalı"

} else {

send(

JSONObject()

.put("gas_threshold", gas)

.put("flame_threshold", flame)

.put("temp_rise", rise)

.put("temp_max", ceiling)

.put("humidity_high", humHighField.toInt())

.put("humidity_low", humLowField.toInt()),

"Eşikler kaydedildi"

)

}

},

enabled = config.canControl

) {

Text("Eşikleri kaydet")

}

}

}

// -------------------------------------------------------------

// Grafik

// -------------------------------------------------------------

Card {

Column(Modifier.padding(16.dp)) {

Text("Grafik", fontWeight = FontWeight.Bold)

Row(

Modifier.padding(vertical = 8.dp),

horizontalArrangement = Arrangement.spacedBy(8.dp)

) {

listOf(1 to "1 dk", 5 to "5 dk", 15 to "15 dk", 60 to "1 saat")

.forEach { (value, label) ->

FilterChip(

selected = minutes == value,

onClick = { minutes = value },

label = { Text(label) }

)

}

}

SensorChart(history, Modifier.fillMaxWidth())

}

}

// -------------------------------------------------------------

// Ayarlar

// -------------------------------------------------------------

Card {

Column(Modifier.padding(16.dp), verticalArrangement = Arrangement.spacedBy(10.dp)) {

Text("Ayarlar", fontWeight = FontWeight.Bold)

var urlField by remember { mutableStateOf(config.baseUrl) }

var tokenField by remember { mutableStateOf(config.token) }

OutlinedTextField(

value = urlField,

onValueChange = { urlField = it },

label = { Text("Sunucu adresi") },

singleLine = true,

modifier = Modifier.fillMaxWidth()

)

OutlinedTextField(

value = tokenField,

onValueChange = { tokenField = it },

label = { Text("Erişim anahtarı (API_TOKEN)") },

singleLine = true,

modifier = Modifier.fillMaxWidth()

)

Button(onClick = {

val next = config.copy(baseUrl = urlField, token = tokenField)

Settings.save(context, next)

config = Settings.load(context)

message = "Ayarlar kaydedildi"

}) {

Text("Kaydet")

}

Row(verticalAlignment = Alignment.CenterVertically) {

Switch(

checked = config.monitorEnabled,

onCheckedChange = { on ->

val next = config.copy(monitorEnabled = on)

Settings.save(context, next)

config = Settings.load(context)

}

)

Text(

" Arka planda izle ve alarmda bildir",

style = MaterialTheme.typography.bodySmall

)

}

}

}

}

}

@Composable

private fun ValueCard(

title: String,

value: String?,

modifier: Modifier = Modifier,

note: String? = null

) {

Card(modifier) {

Column(Modifier.padding(16.dp)) {

Text(title, style = MaterialTheme.typography.labelMedium)

Text(

text = value ?: "--",

style = MaterialTheme.typography.headlineSmall,

fontWeight = FontWeight.Bold

)

if (!note.isNullOrBlank()) {

Text(

text = note,

style = MaterialTheme.typography.labelMedium,

fontWeight = FontWeight.Bold,

color = WARN

)

}

}

}

}

/** "3 dk once" gibi okunabilir yas. */

private fun ageText(seconds: Int?): String {

if (seconds == null) return "zamanı bilinmiyor"

return when {

seconds < 90 -> "$seconds sn önce"

seconds < 5400 -> "${seconds / 60} dk önce"

else -> "${seconds / 3600} saat önce"

}

}

/** Nem uyarisi. Alarm degil: fan, buzzer ve bildirim tetiklenmez. */

private fun humidityNote(humidity: Double?, command: Command?): String? {

if (humidity == null) return null

val high = command?.humidityHigh?.toDouble() ?: HUMIDITY_HIGH_FALLBACK

val low = command?.humidityLow?.toDouble() ?: HUMIDITY_LOW_FALLBACK

return when {

humidity >= high -> "ÇOK NEMLİ"

humidity <= low -> "ÇOK KURU"

else -> null

}

}

@Composable

private fun rememberCoroutineScopeCompat() =

androidx.compose.runtime.rememberCoroutineScope()

MonitorService.kt, the background service

package com.egegurtunca.smartsafety

import android.app.NotificationChannel

import android.app.NotificationManager

import android.app.PendingIntent

import android.app.Service

import android.content.Context

import android.content.Intent

import android.media.AudioAttributes

import android.media.RingtoneManager

import android.os.Build

import android.os.IBinder

import androidx.core.app.NotificationCompat

import kotlinx.coroutines.CoroutineScope

import kotlinx.coroutines.Dispatchers

import kotlinx.coroutines.Job

import kotlinx.coroutines.SupervisorJob

import kotlinx.coroutines.currentCoroutineContext

import kotlinx.coroutines.delay

import kotlinx.coroutines.isActive

import kotlinx.coroutines.launch

/**

* Uygulama kapaliyken de alarmi haber veren foreground service.

*

* Sunucudan push beklemiyoruz: servis kendisi /api/latest'i yokluyor ve

* bildirimi kendisi uretiyor. Boylece Firebase, VAPID, abonelik tablosu

* gibi hicbir sey gerekmiyor.

*/

class MonitorService : Service() {

companion object {

private const val CHANNEL_STATUS = "status"

private const val CHANNEL_ALARM = "alarm"

private const val CHANNEL_OFFLINE = "offline"

private const val STATUS_ID = 1

private const val ALARM_ID = 2

private const val OFFLINE_ID = 3

private const val POLL_MS = 10_000L

fun start(context: Context) {

val intent = Intent(context, MonitorService::class.java)

try {

context.startForegroundService(intent)

} catch (e: Exception) {

// Android 12+ arka plandan foreground service baslatmayi

// kisitliyor. Uygulama acikken cagrildiginda sorun olmaz.

context.startService(intent)

}

}

fun stop(context: Context) {

context.stopService(Intent(context, MonitorService::class.java))

}

}

private val scope = CoroutineScope(SupervisorJob() + Dispatchers.IO)

private var job: Job? = null

// null = henuz olcum yok. Bildirim sadece 0 -> 1 gecisinde atilir,

// alarm surerken tekrar tekrar otmez.

private var lastAlarm: Boolean? = null

// Ayni kenar tetikleme veri akisi kesildiginde de gecerli.

private var lastStale: Boolean? = null

override fun onBind(intent: Intent?): IBinder? = null

override fun onCreate() {

super.onCreate()

createChannels()

startForeground(STATUS_ID, statusNotification("Başlatılıyor..."))

}

override fun onStartCommand(intent: Intent?, flags: Int, startId: Int): Int {

if (job == null) {

job = scope.launch { loop() }

}

// Sistem servisi oldururse yeniden baslatsin.

return START_STICKY

}

override fun onDestroy() {

job?.cancel()

job = null

super.onDestroy()

}

private suspend fun loop() {

while (currentCoroutineContext().isActive) {

poll()

delay(POLL_MS)

}

}

private fun poll() {

val config = Settings.load(this)

if (config.baseUrl.isBlank()) {

updateStatus("Sunucu adresi girilmedi")

return

}

when (val result = Api.latest(config)) {

is ApiResult.Ok -> {

val reading = result.value

if (reading == null) {

updateStatus("Cihazdan veri bekleniyor")

return

}

updateStatus(summary(reading))

// Veri bayatsa cihaz susmus demektir: alarm durumu artik

// gecerli degil. "Normal" demek olu sistemi guvenli

// gostermek olur -- bu sistemin en tehlikeli hata modu.

if (reading.stale) {

if (lastStale != true) {

notifyOffline(reading)

}

lastStale = true

lastAlarm = null

return

}

if (lastStale == true) {

manager().cancel(OFFLINE_ID)

}

lastStale = false

if (reading.alarm && lastAlarm != true) {

notifyAlarm(reading)

}

lastAlarm = reading.alarm

}

is ApiResult.Fail -> updateStatus("Bağlantı yok — ${result.message}")

}

}

private fun summary(reading: Reading): String {

val gas = reading.gas?.toString() ?: "--"

val flame = reading.flame?.toString() ?: "--"

val temperature = reading.temperature

?.let { String.format("%.1f", it) }

?: "--"

if (reading.stale) {

return "VERİ AKIŞI DURDU — son kayıt " + ageText(reading.ageSeconds)

}

return if (reading.alarm) {

"ALARM — Gaz $gas, Alev $flame"

} else {

"Normal — Gaz $gas, Alev $flame, $temperature°C"

}

}

// -----------------------------------------------------------------

// Bildirimler

// -----------------------------------------------------------------

/** "3 dk once" gibi okunabilir yas. */

private fun ageText(seconds: Int?): String {

if (seconds == null) return "zamanı bilinmiyor"

return when {

seconds < 90 -> "$seconds sn önce"

seconds < 5400 -> "${seconds / 60} dk önce"

else -> "${seconds / 3600} saat önce"

}

}

private fun manager(): NotificationManager =

getSystemService(Context.NOTIFICATION_SERVICE) as NotificationManager

private fun createChannels() {

val status = NotificationChannel(

CHANNEL_STATUS,

"Durum",

NotificationManager.IMPORTANCE_LOW

).apply {

description = "Arka planda izleme bildirimi"

setShowBadge(false)

}

val alarm = NotificationChannel(

CHANNEL_ALARM,

"Alarm",

NotificationManager.IMPORTANCE_HIGH

).apply {

description = "Gaz veya alev alarmi"

enableVibration(true)

vibrationPattern = longArrayOf(0, 600, 300, 600, 300, 600)

setSound(

RingtoneManager.getDefaultUri(RingtoneManager.TYPE_ALARM)

?: RingtoneManager.getDefaultUri(RingtoneManager.TYPE_NOTIFICATION),

AudioAttributes.Builder()

.setUsage(AudioAttributes.USAGE_ALARM)

.setContentType(AudioAttributes.CONTENT_TYPE_SONIFICATION)

.build()

)

}

// Alarm kanalindan ayri ve daha sakin: gece yasanan bir WiFi

// kesintisi alarm sesiyle uyandirmasin, ama fark edilmeden de

// gecmesin.

val offline = NotificationChannel(

CHANNEL_OFFLINE,

"Bağlantı",

NotificationManager.IMPORTANCE_DEFAULT

).apply {

description = "Cihazdan veri gelmiyor"

}

manager().createNotificationChannel(status)

manager().createNotificationChannel(alarm)

manager().createNotificationChannel(offline)

}

private fun openAppIntent(): PendingIntent {

val flags =

if (Build.VERSION.SDK_INT >= Build.VERSION_CODES.M)

PendingIntent.FLAG_UPDATE_CURRENT or PendingIntent.FLAG_IMMUTABLE

else

PendingIntent.FLAG_UPDATE_CURRENT

return PendingIntent.getActivity(

this,

0,

Intent(this, MainActivity::class.java),

flags

)

}

private fun statusNotification(text: String) =

NotificationCompat.Builder(this, CHANNEL_STATUS)

.setContentTitle("Smart Safety System")

.setContentText(text)

.setSmallIcon(android.R.drawable.ic_menu_compass)

.setOngoing(true)

.setOnlyAlertOnce(true)

.setPriority(NotificationCompat.PRIORITY_LOW)

.setContentIntent(openAppIntent())

.build()

private fun updateStatus(text: String) {

manager().notify(STATUS_ID, statusNotification(text))

}

private fun notifyAlarm(reading: Reading) {

val reasons = buildList {

reading.gas?.let { add("Gaz: $it") }

reading.flame?.let { add("Alev: $it") }

}.joinToString(" ")

val notification = NotificationCompat.Builder(this, CHANNEL_ALARM)

.setContentTitle("ALARM — Smart Safety System")

.setContentText(reasons.ifBlank { "Alarm tetiklendi" })

.setSmallIcon(android.R.drawable.stat_notify_error)

.setPriority(NotificationCompat.PRIORITY_HIGH)

.setCategory(NotificationCompat.CATEGORY_ALARM)

.setAutoCancel(true)

.setContentIntent(openAppIntent())

.build()

manager().notify(ALARM_ID, notification)

}

private fun notifyOffline(reading: Reading) {

val notification = NotificationCompat.Builder(this, CHANNEL_OFFLINE)

.setContentTitle("Sistem izlenmiyor")

.setContentText(

"Cihazdan veri gelmiyor. Son kayıt " + ageText(reading.ageSeconds) + "."

)

.setSmallIcon(android.R.drawable.stat_notify_error)

.setPriority(NotificationCompat.PRIORITY_DEFAULT)

.setAutoCancel(true)

.setContentIntent(openAppIntent())

.build()

manager().notify(OFFLINE_ID, notification)

}

}

Api.kt, the network code

package com.egegurtunca.smartsafety

import org.json.JSONArray

import org.json.JSONObject

import java.io.BufferedReader

import java.net.HttpURLConnection

import java.net.URL

import java.time.Instant

import java.time.LocalDateTime

import java.time.OffsetDateTime

import java.time.ZoneOffset

data class Reading(

val timeMillis: Long,

/** Kaydin yasi, sunucunun saatiyle. null = olculemedi. */

val ageSeconds: Int?,

/** Sunucu bayat mi diyor? Cihaz susmus olabilir. */

val stale: Boolean,

val temperature: Double?,

val humidity: Double?,

val gas: Int?,

val flame: Int?,

val fan: Boolean,

val alarm: Boolean

)

data class Command(

val fan: Boolean,

val mute: Boolean,

val gasThreshold: Int,

val flameThreshold: Int,

val tempRise: Int,

val tempMax: Int,

val humidityHigh: Int,

val humidityLow: Int

)

sealed class ApiResult<out T> {

data class Ok<T>(val value: T) : ApiResult<T>()

data class Fail(val message: String) : ApiResult<Nothing>()

}

object Api {

private const val TIMEOUT_MS = 10_000

/** Sunucu tarafi -1 gibi sacma esik kabul etmiyor; burada da ayni sinir. */

const val SENSOR_MAX = 1023

/** DHT11 sadece 0-50 C olcuyor; ustundeki tavan hic tetiklenmez. */

const val TEMP_MAX_LIMIT = 50

const val TEMP_RISE_MIN = 1

const val TEMP_RISE_MAX = 30

/** DHT11 nemi 20-90% RH olcuyor; disinda bir esik uyariyi olu birakir. */

const val HUMIDITY_MIN = 20

const val HUMIDITY_MAX = 90

// ---------------------------------------------------------------

// HTTP

// ---------------------------------------------------------------

private fun request(

url: String,

method: String,

token: String?,

body: String?

): Pair<Int, String> {

val connection = URL(url).openConnection() as HttpURLConnection

try {

connection.requestMethod = method

connection.connectTimeout = TIMEOUT_MS

connection.readTimeout = TIMEOUT_MS

if (!token.isNullOrBlank()) {

connection.setRequestProperty("X-Auth", token)

}

if (body != null) {

connection.doOutput = true

connection.setRequestProperty("Content-Type", "application/json")

connection.outputStream.use { it.write(body.toByteArray()) }

}

val code = connection.responseCode

val stream =

if (code in 200..299) connection.inputStream

else connection.errorStream

val text = stream

?.bufferedReader()

?.use(BufferedReader::readText)

.orEmpty()

return code to text

} finally {

connection.disconnect()

}

}

// ---------------------------------------------------------------

// Zaman

//

// Supabase "2026-08-19T11:03:43.318123+00:00" doner, ama kolon

// tipine gore offset'siz de gelebiliyor. Ikisini de kabul et.

// ---------------------------------------------------------------

private fun parseTime(value: String?): Long {

if (value.isNullOrBlank()) return 0L

return try {

OffsetDateTime.parse(value).toInstant().toEpochMilli()

} catch (e: Exception) {

try {

LocalDateTime.parse(value).toInstant(ZoneOffset.UTC).toEpochMilli()

} catch (e2: Exception) {

try {

Instant.parse(value).toEpochMilli()

} catch (e3: Exception) {

0L

}

}

}

}

// ---------------------------------------------------------------

// Ayristirma

// ---------------------------------------------------------------

private fun JSONObject.doubleOrNull(key: String): Double? =

if (isNull(key)) null else optDouble(key).takeIf { !it.isNaN() }

private fun JSONObject.intOrNull(key: String): Int? =

if (isNull(key)) null else optInt(key, Int.MIN_VALUE).takeIf { it != Int.MIN_VALUE }

private fun readingOf(json: JSONObject) = Reading(

timeMillis = parseTime(

if (json.isNull("created_at")) null else json.optString("created_at")

),

temperature = json.doubleOrNull("temperature"),

humidity = json.doubleOrNull("humidity"),

gas = json.intOrNull("gas"),

flame = json.intOrNull("flame"),

ageSeconds = json.intOrNull("age_seconds"),

stale = json.optBoolean("stale", false),

fan = json.optInt("fan", 0) != 0 || json.optBoolean("fan", false),

alarm = json.optInt("alarm", 0) != 0 || json.optBoolean("alarm", false)

)

// ---------------------------------------------------------------

// Uclar

// ---------------------------------------------------------------

fun latest(config: Config): ApiResult<Reading?> = guarded {

val (code, text) = request("${config.baseUrl}/api/latest", "GET", null, null)

if (code !in 200..299) {

return@guarded ApiResult.Fail("Sunucu $code")

}

val json = JSONObject(text)

if (!json.has("created_at")) {

// Henuz hic veri yok.

ApiResult.Ok(null)

} else {

ApiResult.Ok(readingOf(json))

}

}

fun history(config: Config, minutes: Int): ApiResult<List<Reading>> = guarded {

val (code, text) = request(

"${config.baseUrl}/api/history?minutes=$minutes", "GET", null, null

)

if (code !in 200..299) {

return@guarded ApiResult.Fail("Sunucu $code")

}

val array = JSONArray(text)

val rows = ArrayList<Reading>(array.length())

for (i in 0 until array.length()) {

rows.add(readingOf(array.getJSONObject(i)))

}

ApiResult.Ok(rows)

}

fun command(config: Config): ApiResult<Command> = guarded {

val (code, text) = request("${config.baseUrl}/api/command", "GET", null, null)

if (code !in 200..299) {

return@guarded ApiResult.Fail("Sunucu $code")

}

val json = JSONObject(text)

ApiResult.Ok(

Command(

fan = json.optBoolean("fan", false),

mute = json.optBoolean("mute", false),

gasThreshold = json.optInt("gas_threshold", 400),

flameThreshold = json.optInt("flame_threshold", 80),

tempRise = json.optInt("temp_rise", 5),

tempMax = json.optInt("temp_max", 45),

humidityHigh = json.optInt("humidity_high", 80),

humidityLow = json.optInt("humidity_low", 25)

)

)

}

fun sendCommand(config: Config, patch: JSONObject): ApiResult<Unit> = guarded {

val (code, text) = request(

"${config.baseUrl}/api/command", "POST", config.token, patch.toString()

)

when {

code == 401 -> ApiResult.Fail("Erişim anahtarı geçersiz")

code == 503 -> ApiResult.Fail("Sunucuda API_TOKEN tanımlı değil")

code !in 200..299 -> {

val reason = try {

JSONObject(text).optString("error", "Sunucu $code")

} catch (e: Exception) {

"Sunucu $code"

}

ApiResult.Fail(reason)

}

else -> ApiResult.Ok(Unit)

}

}

private inline fun <T> guarded(block: () -> ApiResult<T>): ApiResult<T> =

try {

block()

} catch (e: Exception) {

ApiResult.Fail(e.message ?: "Bağlantı hatası")

}

}

Chart.kt, the chart

package com.egegurtunca.smartsafety

import androidx.compose.foundation.Canvas

import androidx.compose.foundation.layout.Arrangement

import androidx.compose.foundation.layout.Box

import androidx.compose.foundation.layout.Column

import androidx.compose.foundation.layout.Row

import androidx.compose.foundation.layout.fillMaxSize

import androidx.compose.foundation.layout.fillMaxWidth

import androidx.compose.foundation.layout.height

import androidx.compose.foundation.layout.padding

import androidx.compose.foundation.layout.size

import androidx.compose.foundation.shape.CircleShape

import androidx.compose.foundation.background

import androidx.compose.material3.MaterialTheme

import androidx.compose.material3.Text

import androidx.compose.runtime.Composable

import androidx.compose.ui.Alignment

import androidx.compose.ui.Modifier

import androidx.compose.ui.graphics.Color

import androidx.compose.ui.graphics.Path

import androidx.compose.ui.graphics.drawscope.Stroke

import androidx.compose.ui.unit.dp

/**

* Sicaklik/nem 0-100, gaz/alev 0-1023 araliginda. Tek olcege

* sikistirilirsa sicaklik gorunmez olur, o yuzden her serinin

* kendi tavani var.

*/

private data class Series(

val label: String,

val color: Color,

val max: Float,

val value: (Reading) -> Float?

)

private val SERIES = listOf(

Series("Sıcaklık", Color(0xFFEF4444), 100f) { it.temperature?.toFloat() },

Series("Nem", Color(0xFF3B82F6), 100f) { it.humidity?.toFloat() },

Series("Gaz", Color(0xFFF59E0B), 1023f) { it.gas?.toFloat() },

Series("Alev", Color(0xFF10B981), 1023f) { it.flame?.toFloat() }

)

@Composable

fun SensorChart(rows: List<Reading>, modifier: Modifier = Modifier) {

Column(modifier) {

Row(

modifier = Modifier.fillMaxWidth(),

horizontalArrangement = Arrangement.spacedBy(12.dp)

) {

SERIES.forEach { series ->

Row(verticalAlignment = Alignment.CenterVertically) {

Box(

Modifier

.size(8.dp)

.background(series.color, CircleShape)

)

Text(

text = " ${series.label}",

style = MaterialTheme.typography.labelSmall

)

}

}

}

Box(

Modifier

.fillMaxWidth()

.height(200.dp)

.padding(top = 8.dp)

) {

if (rows.size < 2) {

Text(

text = "Grafik için yeterli veri yok",

style = MaterialTheme.typography.bodySmall,

modifier = Modifier.align(Alignment.Center)

)

} else {

val grid = MaterialTheme.colorScheme.onSurface.copy(alpha = 0.15f)

// Kutunun kalan alanini doldur. Sabit 200.dp verilirse

// ustteki 8.dp padding yuzunden alttan kirpilir --

// 0-100 olceginde en altta seyreden sicaklik cizgisi kaybolur.

Canvas(Modifier.fillMaxSize()) {

for (i in 0..4) {

val y = size.height * i / 4f

drawLine(

color = grid,

start = androidx.compose.ui.geometry.Offset(0f, y),

end = androidx.compose.ui.geometry.Offset(size.width, y),

strokeWidth = 1f

)

}

val stepX =

if (rows.size > 1) size.width / (rows.size - 1) else size.width

SERIES.forEach { series ->

val path = Path()

var started = false

rows.forEachIndexed { index, reading ->

val raw = series.value(reading)

if (raw == null) {

// Olcum yok: cizgiyi kopar, uydurma deger cizme.

started = false

return@forEachIndexed

}

val ratio = (raw / series.max).coerceIn(0f, 1f)

val x = stepX * index

val y = size.height - (ratio * size.height)

if (started) {

path.lineTo(x, y)

} else {

path.moveTo(x, y)

started = true

}

}

drawPath(

path = path,

color = series.color,

style = Stroke(width = 3f)

)

}

}

}

}

}

}

Settings.kt, the server address and the key

package com.egegurtunca.smartsafety

import android.content.Context

/**

* Sunucu adresi ve erişim anahtarı. Anahtar koda gömülmez —

* kullanıcı bir kez girer, cihazda kalır.

*/

data class Config(

val baseUrl: String,

val token: String,

val monitorEnabled: Boolean

) {

/** Okuma uçları anahtarsız çalışıyor; izleme için adres yeterli. */

val canMonitor: Boolean

get() = baseUrl.isNotBlank()

/** Fan/susturma/eşik yazmak için anahtar şart. */

val canControl: Boolean

get() = baseUrl.isNotBlank() && token.isNotBlank()

}

object Settings {

private const val FILE = "smart_safety"

private const val KEY_URL = "base_url"

private const val KEY_TOKEN = "token"

private const val KEY_MONITOR = "monitor_enabled"

private const val DEFAULT_URL =

"https://smart-safety-system-y11a.onrender.com"

fun load(context: Context): Config {

val prefs = context.getSharedPreferences(FILE, Context.MODE_PRIVATE)

return Config(

baseUrl = prefs.getString(KEY_URL, DEFAULT_URL).orEmpty().trimEnd('/'),

token = prefs.getString(KEY_TOKEN, "").orEmpty(),

monitorEnabled = prefs.getBoolean(KEY_MONITOR, true)

)

}

fun save(context: Context, config: Config) {

context.getSharedPreferences(FILE, Context.MODE_PRIVATE)

.edit()

.putString(KEY_URL, config.baseUrl.trim().trimEnd('/'))

.putString(KEY_TOKEN, config.token.trim())

.putBoolean(KEY_MONITOR, config.monitorEnabled)

.apply()

}

}

BootReceiver.kt, restart after a reboot

package com.egegurtunca.smartsafety

import android.content.BroadcastReceiver

import android.content.Context

import android.content.Intent

/**

* Telefon yeniden baslatilinca izleme sessizce durmasin.

*

* Android 12+ arka plandan foreground service baslatmayi kisitliyor;

* engellenirse cokmek yerine sessizce vazgeciyoruz -- kullanici

* uygulamayi bir kez actiginda servis yine baslar.

*/

class BootReceiver : BroadcastReceiver() {

override fun onReceive(context: Context, intent: Intent) {

if (intent.action != Intent.ACTION_BOOT_COMPLETED) {

return

}

val config = Settings.load(context)

if (!config.canMonitor || !config.monitorEnabled) {

return

}

try {

MonitorService.start(context)

} catch (e: Exception) {

// Sistem izin vermedi; uygulama acilinca baslayacak.

}

}

}

## 6.7 Server tests

These tests cover the parts of the server that make decisions: thinning out the history data, finding the moment the alarm turns on, checking the threshold ranges, and refusing commands without a key. They do not connect to the database.

"""Calistir: python test_app.py

Supabase'e baglanmaz. Sadece saf mantik ve auth kontrol edilir --

komut hattinin karar veren kisimlari burada.

"""

import os

os.environ.setdefault("API_TOKEN", "test-token")

import app as srv

def test_downsample():

rows = list(range(720))

out = srv.downsample(rows, max_points=120)

assert len(out) == 120, len(out)

assert out[0] == 0, out[0]

assert out[-1] == 719, out[-1]

# Kisa liste dokunulmadan gecer.

short = [1, 2, 3]

assert srv.downsample(short, max_points=120) is short

def test_alarm_edge():

assert srv.alarm_edge(0, 1) == "rise"

assert srv.alarm_edge(1, 0) == "fall"

assert srv.alarm_edge(1, 1) is None

assert srv.alarm_edge(0, 0) is None

# Ilk kayit: onceki satir yok.

assert srv.alarm_edge(None, 1) == "rise"

assert srv.alarm_edge(None, 0) is None

# NodeMCU string gonderirse de ayni sonuc.

assert srv.alarm_edge("0", "1") == "rise"

assert srv.alarm_edge(False, True) == "rise"

def test_command_requires_token():

client = srv.app.test_client()

# Tokensiz yazma reddedilir -- supabase'e hic gidilmez.

assert client.post("/api/command", json={"fan": 1}).status_code == 401

# Yanlis token da reddedilir.

response = client.post(

"/api/command",

json={"fan": 1},

headers={"X-Auth": "yanlis"}

)

assert response.status_code == 401

def test_threshold_validation():

client = srv.app.test_client()

headers = {"X-Auth": os.environ["API_TOKEN"]}

# Sinir disi esik supabase'e ulasmadan reddedilir.

response = client.post(

"/api/command",

json={"gas_threshold": 5000},

headers=headers

)

assert response.status_code == 400, response.status_code

response = client.post(

"/api/command",

json={"gas_threshold": "abc"},

headers=headers

)

assert response.status_code == 400, response.status_code

# Bos govde de reddedilir.

response = client.post("/api/command", json={}, headers=headers)

assert response.status_code == 400, response.status_code

def test_device_command_format():

out = srv.device_command({

"fan_request": True,

"mute": False,

"gas_threshold": 350,

"flame_threshold": 90

})

assert out == {"fan": 1, "mute": 0, "gt": 350, "ft": 90}, out

# Eksik satir varsayilanlara duser, cihaza None gitmez.

out = srv.device_command({})

assert out == {"fan": 0, "mute": 0, "gt": 400, "ft": 80}, out

if __name__ == "__main__":

for name, fn in sorted(globals().items()):

if name.startswith("test_"):

fn()

print("ok", name)

print("hepsi gecti")
