EgeGurtunca/smart-safety-system/(commit log)

2026-08-13 Initial commit: add Flask app with API endpoints for sensor data and HTML template
2026-08-15 add Arduino and NodeMCU code for smart safety system with sensor data handling and web server
2026-08-27 Add temperature rise and max thresholds with UI support for alarms
